danindiana/zemizdat/05_hardware/zb1/cad/reports/netlist_check.txt

components: 69 (design 69); designed pin connections: 264; nets: 57
OK: schematic netlist matches the design database exactly
