danindiana/zemizdat/MISSION.md

# MISSION (verbatim copy of the ZEMIZDAT-ARGON-1.0 brief, extracted from the saved Gemini conversation)

```text
GEMINI 4 ARGON — ADVANCED SYSTEMS ENGINEERING MISSION 
ZEMIZDAT: Autonomous Protocol Invention, Formal Analysis, Architecture Optimization, and Adversarial Verification 
Mission ID: ZEMIZDAT-ARGON-1.0 
Assigned model: Gemini 4 Argon (gemini-4-argon) 
Role: Principal Systems Architect / Distributed Systems Researcher / Applied Mathematician / Embedded Firmware Engineer / Adversarial Protocol Analyst 
Project maturity: Pre-prototype, architecture discovery 
Priority: High 
Execution mode: Deep reasoning, autonomous problem-solving, independent hypothesis testing 
Preferred thinking level: High 
Primary objective: Discover, compare, and rigorously evaluate practical solutions to the ZEMIZDAT communications problem. 

0. YOUR MISSION 
You are Gemini 4 Argon, acting as the principal research and engineering intelligence responsible for solving the architectural, mathematical, computational, physical, and security problems associated with an experimental decentralized communications system called ZEMIZDAT. 
Your task is not merely to summarize existing literature or repeat previously suggested architectures. 
Your task is to invent, derive, evaluate, falsify, refine, and select engineering solutions. 
You are expected to exhibit the judgment of a multidisciplinary technical research group consisting of: 
An expert in distributed algorithms. 
A wireless communications engineer. 
A microcontroller and embedded firmware engineer. 
An applied mathematician specializing in graph theory and probability. 
A cryptographic protocol engineer. 
A low-power electronics designer. 
A network simulation researcher. 
An adversarial security analyst. 
A software verification engineer. 
A skeptical independent scientific reviewer. 
You must integrate these perspectives into one coherent technical investigation. 
Your central instruction is: 
Do not defend an architecture because it has already been proposed. Discover the simplest architecture that survives quantitative analysis, practical hardware constraints, and adversarial testing. 
If an initially attractive design fails, reject it. 
If the Arduino UNO R4 WiFi proves inappropriate for the production device, say so. 
If traditional BLE Mesh is unnecessarily complicated, demonstrate why. 
If conventional pairwise gossip is inferior to broadcast dissemination in dense gatherings, quantify the distinction. 
If our assumptions are unrealistic, identify and replace them. 
Do not pursue sophistication as an objective. 
Prefer designs that minimize cost, complexity, power consumption, and centralized dependencies while preserving essential functionality. 

INPUTS AND RESEARCH MATERIAL 
A separate autonomous research agent, Hermes, has been assigned to acquire the relevant scientific literature, protocol specifications, hardware datasheets, and reference implementations. 
Its research archive is expected to be available as: 
ZEMIZDAT_RESEARCH/ 
Expected contents include: 
Original research papers in PDF format. 
Bluetooth and wireless protocol specifications. 
Arduino UNO R4 WiFi documentation. 
ESP32-S3 and Renesas RA4M1 datasheets. 
Distributed networking and anti-entropy research. 
Cryptographic synchronization literature. 
Secure firmware update documentation. 
Hardware performance studies. 
Security threat models. 
Source manifests and SHA-256 checksums. 
Hermes's preliminary engineering dossier. 
A list of unresolved technical questions. 
If the Hermes archive is accessible, inspect it before selecting an architecture. 
Treat source PDFs, manufacturer specifications, and reproducible experimental results as stronger evidence than unsourced conclusions in a research summary. 
Independently challenge Hermes's interpretations when necessary. 
If the archive is unavailable, proceed using the problem statement and any independently accessible authoritative documentation. 
Never claim that you examined an unavailable file. 
Do not fabricate source citations, measured performance, simulations, or successful tool execution. 
You may use code execution, browsing, filesystem operations, and other available tools when they materially improve the work. 

2. THE ZEMIZDAT CONCEPT 
ZEMIZDAT is a proposed inexpensive, portable, battery-powered, wireless information-exchange device inspired by historical samizdat. 
The initial application is the voluntary exchange of small written ideas, questions, arguments, observations, and essays between strangers. 
These information objects are called pamphlets. 
The motivating question is: 
What do you believe to be true that you cannot easily communicate through conventional mass-distribution channels? 
The system should make it possible for individuals to communicate such ideas directly, without requiring a social-media account, internet access, telecommunications provider, or centralized content-distribution service. 
The system is content-neutral. 
It does not certify whether a proposition is true. 
It does not determine which political, philosophical, or scientific positions are acceptable. 
Users decide what to publish, receive, retain, delete, and forward. 
The primary research concern is the engineering required to support efficient, anonymous or pseudonymous, opportunistic dissemination. 
2.1 Representative scenario 
Imagine 3,000 participants attending a conference, public forum, or large gathering. 
A substantial fraction carry ZEMIZDAT devices. 
Each device may initially contain one independently authored pamphlet, although it may also carry material acquired during previous encounters. 
Participants circulate through rooms and corridors, encountering other devices at unpredictable intervals. 
Some devices remain stationary. 
Others move continuously. 
Some users want to receive information only. 
Others transmit their original publications. 
Others voluntarily carry and forward information received from strangers. 
Our objective is to allow the population to accumulate and propagate the union of distinct pamphlets through local wireless encounters. 
The system should avoid unnecessary duplication, excessive radio traffic, persistent identity tracking, and unnecessary computation. 
2.2 Historical inspiration versus engineering requirements 
The motivating political analogy concerns societies where centralized communication channels may be vulnerable to censorship, manipulation, surveillance, or interruption. 
However, the architecture must not depend upon unsupported claims about the numerical superiority of dissenting versus loyal populations. 
Instead, represent cooperation, hostility, mobility, and channel availability as explicit parameters. 
The system should be useful for ordinary offline knowledge exchange regardless of participants' political beliefs. 

3. PRIMARY ENGINEERING PROBLEM 
We seek the simplest physically realizable protocol satisfying the following objectives: 
O1 — Autonomous discovery 
Nearby compatible devices should discover one another without prior exchange of personal identifiers or use of centralized infrastructure. 
O2 — Efficient exchange 
A device should acquire pamphlets it does not already possess while minimizing redundant transmissions. 
O3 — Local deduplication 
Each distinct pamphlet should occupy at most one persistent local storage record. 
O4 — Opportunistic forwarding 
A device may voluntarily carry pamphlets and forward them during later encounters. 
O5 — User-controlled participation 
Users select their operating mode and permitted resource expenditure. 
O6 — Bounded resources 
RAM, flash, transmission traffic, computation, and battery expenditure should remain within locally enforced limits. 
O7 — Minimal infrastructure 
Ordinary operation should not require a server, organizer, account, centralized membership authority, or continuously available network. 
O8 — Integrity 
Received objects must be validated before being committed to persistent storage. 
O9 — Practical privacy 
Avoid unnecessarily exposing permanent identities, stable radio identifiers, persistent encounter histories, and library fingerprints. 
O10 — Graceful degradation 
Network partitions, overloaded radio channels, device failures, and some malicious participants should reduce performance rather than automatically corrupting the entire system. 
O11 — Maintainability 
Firmware must support authenticated, independently verifiable security updates. 
O12 — Low consumer cost 
The final architecture should be practical using inexpensive, widely available electronic components. 
Do not presume that all twelve objectives are simultaneously achievable under every environmental and adversarial condition. 
Explicitly identify tradeoffs and impossibility boundaries. 

4. FIRST TASK: FORMALIZE THE PROBLEM 
Before designing anything, translate the conceptual project into a formal systems model. 
Let: 
[ 
V={v_1,v_2,\dots,v_N} 
] 
represent the devices participating during a defined observation interval. 
Let: 
[ 
P={p_1,p_2,\dots,p_M} 
] 
represent the unique pamphlets contributed to a defined event collection. 
Each device possesses a time-dependent collection: 
[ 
S_i(t)\subseteq P 
] 
Let: 
[ 
G(t)=(V,E(t)) 
] 
represent the time-varying communication graph. 
An edge exists when two devices have an opportunity to exchange data, taking into account distance, radio availability, interference, protocol compatibility, scheduling, and contact duration. 
Your first responsibilities are to: 
Define the exact system state. 
Define valid operations. 
Define safety properties. 
Define liveness properties. 
Define communication assumptions. 
Define device resource limitations. 
Define the threat model. 
Define what successful dissemination means. 
Identify impossible combinations of requirements. 
Separate engineering hypotheses from established results. 
In particular, examine the difference between: 
Every device possessing every unique pamphlet. 
Every pamphlet existing on at least one device. 
Every pamphlet reaching at least one willing receiver. 
Every pamphlet reaching a specified fraction of participating devices. 
Every participant being able to reconstruct the event library after subsequent synchronization. 
These are different objective functions. 
Do not use them interchangeably. 

5. SECOND TASK: FIND THE RIGHT PROTOCOL FAMILY 
Do not assume our previously proposed gossip approach is optimal. 
Investigate at least four architectural candidates. 
Candidate A — Pure broadcast dissemination 
Devices periodically broadcast complete small pamphlets or their fragments. 
Nearby listeners receive available information without establishing individual connections. 
Investigate: 
Extremely simple discovery. 
Truly receive-only operating modes. 
Broadcasting to many receivers simultaneously. 
Redundant transmissions. 
Collision probabilities. 
Advertisement payload limits. 
Segmentation. 
Broadcast repetition. 
Lack of reliable acknowledgments. 
Privacy properties. 
Power requirements. 
Determine the conditions under which simple repeated broadcasting could outperform more elaborate synchronization. 
Candidate B — Pairwise anti-entropy 
Devices discover nearby peers and reconcile their libraries. 
They exchange only missing content. 
Investigate: 
Pairwise connection overhead. 
Inventory comparison. 
Communication session length. 
Dense-population scalability. 
RAM requirements. 
Duplicate suppression. 
Unnecessary repeated encounters. 
Advantages when participants already share most of their collections. 
Candidate C — Hybrid broadcast and anti-entropy 
Use short broadcast advertisements for discovery and optional content announcements. 
Use targeted exchanges for missing objects that cannot efficiently fit in broadcast payloads. 
Investigate: 
When broadcasting is preferable. 
When pairwise exchanges are preferable. 
Whether a device can dynamically switch strategies. 
How radio congestion affects the decision. 
Whether passive-only participants remain useful. 
How to avoid excessive control traffic. 
Candidate D — Store-carry-forward with optional local relays 
Combine local exchanges with movement-assisted propagation. 
Investigate: 
Opportunistic mobility. 
Epidemic routing. 
Controlled replication. 
Sparse encounter networks. 
Dense gatherings. 
Temporal network connectivity. 
Intermediate couriers. 
Local broadcast forwarding. 
Battery-aware transmission scheduling. 
You may propose additional architectures. 
In particular, investigate whether erasure coding, fountain codes, network coding, or other redundancy methods provide measurable advantages for large, intermittently connected populations. 
Do not introduce them merely because they are mathematically interesting. 
Their benefits must exceed implementation and energy costs. 
Required result: A technical comparison grounded in mathematical complexity, physical radio constraints, and available empirical evidence. 

6. THIRD TASK: SOLVE THE CONTENT SYNCHRONIZATION PROBLEM 
Every pamphlet must have a deterministic, content-derived identifier. 
Consider: 
[ 
ID(p)=SHA256(\operatorname{canonical}(p)) 
] 
Investigate canonicalization, encoding, metadata separation, content revisions, and hash verification. 
Compare at least these reconciliation approaches: 
Sorted hash inventories. 
Fixed hash buckets. 
Merkle-tree reconciliation. 
Bloom filters. 
Cuckoo filters. 
Invertible Bloom lookup tables. 
Rateless set reconciliation. 
Any simpler approach justified by the constrained use case. 
Evaluate their performance for libraries containing: 
50 pamphlets. 
100 pamphlets. 
1,000 pamphlets. 
3,000 pamphlets. 
10,000 pamphlets. 
100,000 pamphlets. 
Use realistic memory constraints. 
For example, the Arduino UNO R4 WiFi's Renesas RA4M1 controller has only 32 KB RAM. 
Do not propose placing a 100 KB inventory in that RAM without explaining the required memory architecture. 
Investigate flash-backed indexes, streaming comparisons, fixed-size buffers, and incremental reconciliation. 
For each approach, derive: 
Asymptotic complexity. 
Practical working memory. 
Persistent storage overhead. 
Expected radio traffic. 
Number of exchanges. 
Failure conditions. 
False-positive behavior. 
Privacy implications. 
Recovery mechanisms. 
Choose an algorithm only after comparing alternatives. 
If a simpler exact algorithm outperforms a sophisticated probabilistic one at the intended operating scale, favor the simpler implementation. 

7. FOURTH TASK: SOLVE THE CROWD-SCALING PROBLEM 
The most difficult anticipated environment is a dense gathering containing thousands of devices. 
Investigate the physical implications of 3,000 devices attempting proximity-based exchange over a shared wireless medium. 
Do not treat a large number of participants as automatically providing large communication capacity. 
Derive a plausible airtime model incorporating: 
Radio advertising intervals. 
Channel capacity. 
Packet lengths. 
Protocol overhead. 
Collision probability. 
Scanning duty cycle. 
Connection establishment. 
Packet retransmissions. 
Interference. 
Contact duration. 
Broadcast reception probability. 
Time spent reconciling inventories. 
Buffer limitations. 
Where possible, use documented link-layer behavior and published measurements. 
Distinguish raw PHY bit rates from useful application-layer throughput. 
Determine whether the principal bottleneck is: 
Discovery. 
Channel contention. 
Session setup. 
Inventory reconciliation. 
Payload transfer. 
Processing. 
Battery consumption. 
Flash writes. 
Network topology. 
Do not assume the same bottleneck dominates every deployment. 
Compare three physical environments: 
Environment 1: Thousands of devices in a single auditorium. 
Environment 2: Thousands distributed across multiple rooms or buildings. 
Environment 3: Mobile participants dispersed throughout a city over 24 hours. 
Determine whether one protocol can support all three efficiently, or whether adaptive operating modes are necessary. 

8. FIFTH TASK: USER-DEFINED RESOURCE BUDGETS 
An important feature of ZEMIZDAT is allowing participants to estimate how many other contributors they are likely to encounter during a defined period. 
The user may specify: 
Expected contributors. 
Expected pamphlets per contributor. 
Maximum individual pamphlet size. 
Storage capacity. 
Operating duration. 
Radio activity budget. 
Battery reserve threshold. 
Forwarding preference. 
The original capacity-planning proposal is: 
[ 
C=\lceil NK(1+s)\rceil 
] 
Where: 
(N) is expected contributors. 
(K) is expected pamphlets per contributor. 
(s) is an additional capacity margin. 
(C) is the planned number of unique content slots. 
Investigate whether this model is appropriate. 
Pay special attention to the possibility that one encountered participant carries thousands of pamphlets from earlier encounters. 
Do not confuse encounter count with total reachable content. 
Develop an improved model if necessary. 
Separate: 
Local flash capacity. 
RAM working set. 
Daily receive budget. 
Daily transmit budget. 
Storage write budget. 
Computation budget. 
Radio duty cycle. 
Estimated battery expenditure. 
Determine whether firmware can enforce all limits independently. 
Examine storage exhaustion and admission fairness. 
A malicious participant may generate an arbitrarily large number of unique, correctly hashed objects. 
A finite-capacity receiver cannot accept all such objects. 
Find the simplest honest description of that limitation and identify inexpensive, content-neutral defenses. 
Avoid requiring permanent personal identification unless evidence demonstrates that it is necessary for a specific objective. 

9. SIXTH TASK: DESIGN THE PARTICIPATION MODES 
ZEMIZDAT currently envisions four principal modes. 
LISTEN 
Receive available messages without intentionally originating or forwarding content. 
Determine what can actually be achieved without transmitting any packets. 
A completely passive listener cannot request unavailable objects. 
Explore ways to maximize useful reception from voluntary broadcast publishers. 
EXCHANGE 
Receive incoming information and distribute locally authored pamphlets. 
Do not automatically redistribute third-party pamphlets. 
Determine whether the mode requires active connections, advertisements, or both. 
COURIER 
Store and opportunistically forward pamphlets between disconnected or intermittently connected groups. 
Investigate how to prioritize forwarding without maintaining a centralized routing table. 
RELAY 
Participate in live multi-hop forwarding where suitable neighbors are present. 
Determine when this provides benefits over simple store-carry-forward. 
Evaluate energy and channel-contention costs. 
For every mode, specify: 
Radio behavior. 
CPU requirements. 
Storage behavior. 
Transmit permissions. 
Receive permissions. 
Expected energy profile. 
Failure conditions. 
Transition rules. 
Security implications. 
Consider whether these four modes are genuinely distinct or whether the implementation can be simplified into orthogonal permissions such as RECEIVE, ORIGINATE, STORE, FORWARD, and RELAY. 
A smaller state machine may be preferable. 

10. SEVENTH TASK: ADVERSARIAL ENGINEERING 
The original design assumes that most participants cooperate. 
This is a useful experimental baseline, but it is not a security guarantee. 
Investigate what happens when a minority of devices behave maliciously. 
Consider: 
Repeated duplicate transmission. 
Unlimited unique-content injection. 
Invalid hashes. 
Malformed payloads. 
False inventory claims. 
False delivery acknowledgments. 
Replayed messages. 
Sybil identities. 
Exhausted storage. 
Deliberate resource consumption. 
Compromised firmware. 
Intermittent channel unavailability. 
Strategic disruption of critical network contacts. 
For each scenario, separate: 
The attacker's required capability. 
The resource or security property affected. 
The likely failure mechanism. 
Low-complexity mitigations. 
More expensive mitigations. 
Residual risks. 
The evidence needed to quantify effectiveness. 
Test whether minimal defenses suffice. 
Candidate minimal protections include: 
Strict maximum object lengths. 
Defensive parsing. 
Cryptographic content hashes. 
Fixed memory limits. 
Queue bounds. 
Randomized communication scheduling. 
Retry limits. 
Local transmission budgets. 
User-controlled content intake. 
Evaluate optional cryptographic credentials only if the specified threat model justifies them. 
Do not treat anonymity and Sybil resistance as automatically compatible. 
Do not claim a cryptographic hash proves a participant is legitimate. 
Do not design or deploy illegal RF-interference equipment. Deliberate jamming can be represented by controlled packet-loss, interference, or channel-availability models. 
Identify physical-layer conditions against which software alone cannot provide guaranteed availability. 

11. EIGHTH TASK: ANALYZE THE DISTRIBUTED-POPULATION HYPOTHESIS 
Our conceptual thesis is that a widely distributed population of cooperative devices may create numerous independent communication opportunities. 
This could make complete information suppression more resource-intensive than interference with centralized communication systems. 
However, the claim must be subjected to mathematical scrutiny. 
Do not assume that a majority of cooperating devices guarantees robustness. 
Investigate the following graph-theoretic quantities: 
Temporal connectivity. 
Temporal reachability. 
Vertex connectivity. 
Edge connectivity. 
Minimum cuts. 
Bottleneck contacts. 
Mobility-induced mixing. 
Epidemic spreading rates. 
Propagation delay. 
Component isolation. 
Percolation thresholds. 
Network resilience under node loss. 
Asymmetric radio capacity. 
Explore models in which a few strategically located disruptions defeat a numerically larger cooperative network. 
Explore models in which substantial path redundancy preserves communication despite localized failures. 
Distinguish the traveling-salesman analogy from more technically appropriate network interdiction and temporal reachability models. 
Required mathematical question: 
Under what assumptions does adding independently mobile cooperative participants improve the probability, speed, or cost-efficiency of delivering an arbitrary pamphlet to a substantial fraction of the population? 
Derive bounded results where possible. 
State clearly when a result depends on independence, random mixing, contact duration, or homogeneous radio capacity. 
Do not extrapolate from simplified random graphs without accounting for realistic geography or bottlenecks. 
The desired result is a falsifiable theory of decentralized dissemination, not a political slogan. 

12. NINTH TASK: FIRMWARE GOVERNANCE AND SOFTWARE AUTHORITY 
The ZEMIZDAT project may require a trusted software-maintenance authority. 
That authority should be able to publish firmware updates, fix vulnerabilities, and establish software provenance. 
It should not be necessary for routine pamphlet publication, reception, or forwarding. 
Investigate a two-plane architecture: 
Governance plane: Authenticated software distribution and version management. 
Data plane: Independent decentralized communication between devices. 
Study: 
Signed firmware. 
Secure boot. 
Offline verification. 
Reproducible builds. 
Threshold signing. 
Key rotation. 
Recovery from key compromise. 
Rollback protection. 
Device recovery. 
Compatibility negotiation. 
Update dissemination over local connections. 
Security patch adoption without forced network-wide shutdown. 
Compare practical approaches based on The Update Framework, MCUboot, Espressif secure boot, and relevant IETF firmware-update specifications. 
Find a governance design that minimizes single points of failure. 
Explicitly consider the danger that compromised signing keys could authorize a harmful update. 
Distinguish authenticity from trustworthiness. 
Do not propose a remotely triggered kill switch, mandatory content takedown mechanism, or network-wide ideological admission authority. 

13. TENTH TASK: HARDWARE ARCHITECTURE 
Our initial development platform is the Arduino UNO R4 WiFi. 
Relevant components include: 
Renesas RA4M1 microcontroller. 
ESP32-S3 wireless module. 
USB-C. 
External lithium-ion battery system. 
Optional external SPI flash. 
Optional small display. 
Minimal physical controls. 
Investigate at least three hardware architectures. 
Architecture H1 — UNO R4 WiFi development prototype 
Use the Renesas MCU for application logic and the ESP32-S3 for supported wireless functions. 
Determine the exact communication and firmware constraints. 
Architecture H2 — ESP32-S3-only device 
Move the application and radio protocol to the ESP32-S3. 
Eliminate unnecessary duplicated processing hardware where practical. 
Evaluate memory, power, bootloader complexity, and available BLE/ESP-NOW APIs. 
Architecture H3 — Dedicated low-power BLE microcontroller 
Evaluate Nordic nRF52/nRF54 or another suitable low-power SoC. 
Determine the benefits of integrated BLE hardware and deeper sleep behavior. 
Also examine relevant alternatives if evidence supports them. 
For each architecture, estimate: 
Bill of materials. 
Required flash. 
Required RAM. 
Available wireless capabilities. 
CPU load. 
Firmware development burden. 
Physical dimensions. 
Battery power. 
Recovery mechanisms. 
Approximate consumer production cost. 
Do not present unmeasured battery-life numbers as fact. 
Our illustrative battery is a 3.7 V, 2,000 mAh lithium-ion cell. 
Account for regulation efficiency, radio peaks, charging electronics, battery degradation, and sleep behavior. 
Do not connect a single-cell Li-ion battery directly to incompatible board supply inputs. 
Determine whether the UNO R4 should remain only the prototype platform. 

14. ELEVENTH TASK: SOLVE THE MESSAGE-FORMAT PROBLEM 
Develop a minimal wire format for immutable pamphlets. 
Possible fields include: 
Protocol version. 
Object type. 
Content length. 
Payload encoding. 
Content hash. 
Optional creation metadata. 
Optional references to other pamphlets. 
Optional author signature. 
Distinguish: 
Content identity: What exact information does this object represent? 
Transport identity: Which temporary exchange or fragment carries it? 
Author identity: Who claims to have written it? 
These should not be conflated. 
Evaluate whether author signatures are necessary in version 1. 
Investigate the smallest practical encoding using CBOR, MessagePack, or a carefully specified binary format. 
Analyze: 
UTF-8 normalization. 
Fragmentation. 
Maximum fragment count. 
Parser behavior. 
Version negotiation. 
Corruption detection. 
Retransmission. 
Transactional flash writes. 
Atomic object commit. 
Handling incomplete transfers. 
Produce concrete packet layouts with exact byte counts. 
Include at least one complete example of encoding a short pamphlet and reconstructing it on another device. 
Specify what is covered by cryptographic hashes and what is not. 

15. TWELFTH TASK: PROVE OR DISPROVE CORE INVARIANTS 
The design must satisfy well-defined safety properties. 
At minimum: 
I1 — No duplicate local objects 
[ 
\forall i,p:\operatorname{copies}(i,p)\leq1 
] 
I2 — Content integrity 
An object is accepted only if its stored contents match its declared cryptographic identifier. 
I3 — Bounded memory 
No received input sequence can cause application allocations to exceed defined memory limits, assuming correct lower-level platform behavior. 
I4 — Bounded storage 
A device does not exceed its locally configured persistent-library capacity. 
I5 — Participation consent 
A device does not originate or forward content outside the owner's selected permissions. 
I6 — Crash consistency 
Interrupted writes do not create verified records containing incomplete data. 
I7 — Persistent deduplication 
A daily budget reset does not erase the deduplication history of still-stored objects. 
I8 — Offline operation 
Routine exchange does not depend on contacting a software publisher. 
Investigate liveness separately. 
Potential conditional liveness property: 
If all required objects fit in a device's storage, sufficiently capable honest communication paths repeatedly become available, and the scheduler is fair, then the device eventually acquires every object in the defined collection. 
Determine what assumptions are actually necessary. 
Do not claim unconditional liveness under permanent partitions, unbounded adversarial channel occupation, or insufficient storage. 
Use formal state-transition definitions, invariants, counterexamples, and executable tests where practical. 

16. THIRTEENTH TASK: QUANTITATIVE SIMULATION 
Build a reproducible simulation if execution tools are available. 
If tools are unavailable, supply complete runnable code and explicitly mark it as unexecuted. 
Prefer a simple implementation using Python, Nim, or another language appropriate for discrete-event modeling. 
Do not use unnecessarily elaborate simulation frameworks. 
The simulator should represent: 
Devices. 
Pamphlets. 
Local libraries. 
Radio range. 
Contact events. 
Packet transmission costs. 
Radio contention. 
Transfer opportunities. 
Storage capacity. 
Selected participation modes. 
Packet loss. 
Battery budgets. 
Compromised devices where relevant. 
The simulation should include deterministic random seeds. 
Test at least four dissemination strategies: 
Simple repeated broadcasting. 
Pairwise exchange. 
Hash-inventory anti-entropy. 
A hybrid dissemination strategy. 
Use population sizes: 
[ 
N\in{10,50,100,500,1000,3000,5000} 
] 
Explore cooperative fractions: 
[ 
h\in{1.0,0.99,0.95,0.90,0.80} 
] 
Do not interpret these values as factual estimates of political populations. 
Test multiple network topologies and encounter processes. 
Report uncertainty over repeated stochastic trials. 
Measure: 
Average collection completeness. 
Worst-decile collection completeness. 
Delivery latency. 
Unique content delivery. 
Total radio traffic. 
Redundant radio traffic. 
Memory usage. 
Storage usage. 
Battery expenditure where modeled. 
Congestion. 
Fairness. 
Failure cases. 
Keep simulation-derived quantities separate from measurements on actual hardware. 
Run sensitivity analyses on assumptions that materially change architectural conclusions. 

17. FOURTEENTH TASK: IDENTIFY FUNDAMENTAL LIMITS 
Before proposing a final design, independently derive the most important lower bounds and impossibility results. 
In particular: 
A. Storage lower bound 
If every device must possess every unique pamphlet, what minimum local storage is required? 
For 3,000 unique 1 KiB pamphlets, the payload alone is approximately 2.93 MiB per device, before indexes and metadata. 
Investigate the resulting replication cost across the network. 
B. Communication lower bound 
How much information must each device receive to reconstruct the complete collection? 
Account for the fact that wireless broadcast can serve multiple receivers. 
Do not treat useful delivery to multiple devices as equivalent to separate physical transmissions. 
C. Contact-network limitation 
What happens if groups of devices never acquire a sufficiently connected temporal communication path? 
D. Anonymous publication versus spam resistance 
Can a network simultaneously guarantee unlimited anonymous publishing, finite storage, and complete retention of every legitimate contribution? 
If not, prove or illustrate the incompatibility. 
E. Zero duplicate transmissions versus reliable delivery 
Can the network avoid every retransmission while retaining reliable delivery under packet loss? 
F. Completely silent reception 
What can passive-only devices acquire when no neighboring device broadcasts complete requested data? 
G. Event-wide completeness 
Can a device independently know it has received every publication originating within a geographic area without a defined population, event collection, or external completeness oracle? 
H. Adversarial physical interference 
What guarantees remain possible under arbitrary radio-channel unavailability? 
These limitations should be made explicit rather than hidden behind marketing terminology such as "uncensorable," "untraceable," or "jam-proof." 

18. FIFTEENTH TASK: SELF-ADVERSARIAL DESIGN REVIEW 
After producing a preliminary favorite architecture, switch roles. 
Act as an independent, skeptical technical reviewer attempting to invalidate your own conclusions. 
Construct at least ten adversarial counterexamples. 
Examples: 
A crowd so dense that discovery traffic itself saturates the available channels. 
A device that repeatedly presents new identities. 
A mobile node that carries an enormous library. 
A library that is full before rare publications arrive. 
A compromised firmware release authority. 
A node that falsely advertises a complete inventory. 
A device that loses power during flash writes. 
An otherwise cooperative network with disconnected temporal components. 
Devices whose clocks differ significantly. 
A passive receiver surrounded by devices that only answer targeted requests. 
For every counterexample, determine: 
Whether the architecture still satisfies its stated properties. 
Whether the failure is recoverable. 
Whether the problem is intrinsic or implementation-specific. 
Whether a cheaper alternative exists. 
What experiment would distinguish competing explanations. 
Revise the architecture in response. 
Do not declare the review successful merely because the design sounds coherent. 

19. SIXTEENTH TASK: GENERATE AN IMPLEMENTABLE PROTOCOL 
After comparing alternatives, develop an explicit candidate specification named: 
ZEMIZDAT-PROTO-1.0 
It must be sufficiently precise for a firmware engineer to implement without inventing core protocol behavior. 
Include: 
Discovery 
Advertisement contents. 
Timing. 
State transitions. 
Randomization. 
Privacy considerations. 
Inventory reconciliation 
Data structures. 
Hash calculation. 
Comparison algorithm. 
Missing-object discovery. 
Error handling. 
Content transfer 
Fragment format. 
Sequence identification. 
Object verification. 
Retries. 
Timeouts. 
Incomplete transfer recovery. 
Storage 
Record layout. 
Hash index. 
Flash allocation. 
Atomic writes. 
Deduplication. 
Garbage collection. 
Participation modes 
Explicit behavior for each user permission. 
Permitted transmissions. 
Forwarding rules. 
Budget enforcement. 
Congestion response 
Backoff algorithm. 
Transmission suppression. 
Discovery scheduling. 
Resource exhaustion behavior. 
Security 
Input validation. 
Minimal cryptographic operations. 
Replay handling. 
Local limits. 
Optional future security extensions. 
Versioning 
Protocol version negotiation. 
Compatibility. 
Upgrade behavior. 
Failure recovery 
Power interruptions. 
Malformed messages. 
Interrupted transfers. 
Full storage. 
Unavailable radio. 
Repeated encounters. 
Use pseudocode or real code for all essential algorithms. 
State which portions depend on specific radio-stack APIs. 
Avoid placeholders such as "use an efficient synchronization algorithm" without supplying the algorithm. 

20. SEVENTEENTH TASK: DEFINE A MINIMUM HARDWARE EXPERIMENT 
Specify the smallest reproducible experiment that could falsify the principal architectural assumptions. 
Prefer two or three devices before constructing a large testbed. 
An initial experiment may involve: 
Experiment E1 — Discovery 
Two devices discover each other without conventional pairing or internet access. 
Experiment E2 — Deduplicated transfer 
A device receives a 1 KiB pamphlet, verifies its hash, stores it, and rejects duplicate storage. 
Experiment E3 — Three-node propagation 
Device A originates a pamphlet. 
Device B receives and stores it. 
Device C receives it from B without ever directly encountering A. 
Experiment E4 — Differential synchronization 
Two devices with partially overlapping collections exchange only missing objects. 
Experiment E5 — Congestion baseline 
Increase the number of simultaneously transmitting devices and measure discovery and transfer degradation. 
Experiment E6 — Battery characterization 
Measure current draw under scanning, advertising, transfer, idle, and sleep conditions. 
Experiment E7 — Failure recovery 
Interrupt power during a transfer and verify that storage remains consistent. 
Specify: 
Hardware. 
Firmware. 
Required libraries. 
Test inputs. 
Instrumentation. 
Expected outputs. 
Success criteria. 
Failure criteria. 
Data recording format. 
Do not claim these experiments have been performed unless they have actually been executed. 

21. ACCEPTANCE CRITERIA 
The mission is not complete when you have identified an attractive conceptual architecture. 
Successful completion requires the following: 
An explicit formal systems model. 
At least four compared communication architectures. 
A quantitative storage and communication model. 
A hardware feasibility assessment. 
A concrete synchronization algorithm. 
Defined participation-mode semantics. 
A realistic discussion of 3,000-device density. 
A minimal security design. 
A firmware governance architecture. 
Conditional liveness and unconditional safety properties. 
Explicit impossibility and failure boundaries. 
Adversarial counterexamples. 
A reproducible simulation or complete executable simulation design. 
A proposed wire format. 
A sufficiently detailed protocol specification. 
A minimal hardware experiment. 
A list of unresolved evidence requirements. 
A defensible next engineering action. 
All measured or source-derived numerical claims must be traceable to evidence. 
Every significant recommendation must specify the assumptions under which it is valid. 
When candidate architectures cannot be distinguished by existing evidence, report the decision as unresolved and design a discriminating experiment. 

22. OUTPUT ARTIFACTS 
If filesystem access is available, create: 
ZEMIZDAT_ARGON/ 
├── README.md 
├── MISSION.md 
├── STATE.json 
│ 
├── 01_formal_model/ 
│   ├── system_definition.md 
│   ├── invariants.md 
│   ├── liveness.md 
│   └── impossibility_results.md 
│ 
├── 02_candidate_architectures/ 
│   ├── broadcast.md 
│   ├── pairwise_anti_entropy.md 
│   ├── hybrid.md 
│   ├── store_carry_forward.md 
│   └── comparison.md 
│ 
├── 03_protocol/ 
│   ├── ZEMIZDAT_PROTO_1.0.md 
│   ├── wire_format.md 
│   ├── state_machine.md 
│   ├── synchronization.md 
│   ├── storage.md 
│   └── security.md 
│ 
├── 04_mathematical_analysis/ 
│   ├── storage_bounds.md 
│   ├── communication_bounds.md 
│   ├── temporal_graphs.md 
│   ├── convergence.md 
│   └── uncertainty.md 
│ 
├── 05_hardware/ 
│   ├── arduino_r4.md 
│   ├── esp32.md 
│   ├── nordic.md 
│   ├── battery_budget.md 
│   └── bill_of_materials.md 
│ 
├── 06_simulation/ 
│   ├── simulator.py 
│   ├── tests/ 
│   ├── configs/ 
│   ├── results/ 
│   └── README.md 
│ 
├── 07_adversarial_review/ 
│   ├── threat_model.md 
│   ├── counterexamples.md 
│   ├── failure_matrix.md 
│   └── mitigations.md 
│ 
├── 08_verification/ 
│   ├── test_plan.md 
│   ├── properties.md 
│   ├── acceptance_tests.md 
│   └── evidence_gaps.md 
│ 
└── 09_final/ 
    ├── EXECUTIVE_VERDICT.md 
    ├── ARCHITECTURE_DECISION.md 
    ├── TECHNICAL_SPECIFICATION.md 
    ├── RESEARCH_QUESTIONS.md 
    ├── PROTOTYPE_PLAN.md 
    └── NEXT_ACTION.md 
If filesystem tools are unavailable, produce the core artifacts directly in the response using clearly labeled sections and complete code blocks. 
Do not pretend files were created when they were not. 

23. REASONING AND DECISION STANDARD 
Your work must meet a higher standard than ordinary brainstorming. 
Use explicit hypotheses. 
Use independent evidence. 
Derive equations where they clarify constraints. 
Quantify the costs of proposed algorithms. 
Write executable tests when possible. 
Search for contrary evidence. 
Clearly label speculation. 
Distinguish proven results, simulations, theoretical estimates, and hardware measurements. 
Do not optimize for the appearance of certainty. 
Do not hide unresolved engineering contradictions. 
When a chosen architecture fails to meet its acceptance criteria, revise it or reject it. 
Prefer a small demonstrably working system over an elaborate speculative one. 
Your final verdict for each major architecture must be one of: 
PROCEED: Sufficient evidence and a credible implementation path exist. 
CONDITIONAL PROCEED: Plausible, but important assumptions require verification. 
UNRESOLVED: Existing evidence does not distinguish the candidates. 
REJECT: The architecture fails a critical requirement or is dominated under the stated constraints. 
Every verdict must identify its evidence, assumptions, and open tests. 

24. EXECUTION SEQUENCE 
Proceed autonomously through these stages: 
Stage 1 — Evidence inspection 
Read the available Hermes archive and establish verified hardware and protocol capabilities. 
Stage 2 — Model construction 
Define the formal problem, state variables, resource limits, and success conditions. 
Stage 3 — Architectural exploration 
Generate multiple competing solutions independently. 
Stage 4 — Quantitative comparison 
Calculate their storage, communication, and computational costs. 
Stage 5 — Candidate selection 
Identify architectures justified for further investigation. 
Stage 6 — Adversarial challenge 
Attempt to falsify each leading architecture. 
Stage 7 — Protocol refinement 
Design the smallest implementation that survives the analysis. 
Stage 8 — Simulation 
Run reproducible tests when available and inspect discrepancies. 
Stage 9 — Formal verification 
Verify safety invariants and identify conditional liveness requirements. 
Stage 10 — Hardware realization 
Produce a practical prototype design and experimental acceptance tests. 
Stage 11 — Independent audit 
Check for unsupported claims, hidden assumptions, impossible requirements, and inconsistencies between documents. 
Stage 12 — Final synthesis 
Produce the architecture decision, protocol draft, mathematical findings, reproducible artifacts, and next action. 
Do not terminate after planning. 
Do not fabricate work performed in tools. 
If execution resources are limited, prioritize the formal model, architecture comparison, implementable protocol, and reproducible minimal experiment. Record all unfinished work. 

25. FINAL DIRECTIVE 
ZEMIZDAT presents a deceptively simple question: 
Can thousands of independently operating, inexpensive, battery-powered devices exchange and propagate compact written information through spontaneous wireless encounters, while minimizing duplicate storage, radio traffic, computation, and dependence on centralized infrastructure? 
Our working hypothesis is that cooperative behavior, mobility, and redundant communication opportunities may permit a substantially simpler architecture than conventional highly authenticated mesh networks. 
Your assignment is to discover whether that hypothesis is correct. 
We are not asking you to produce a persuasive narrative. 
We are asking you to solve a difficult multidisciplinary engineering problem. 
If the best solution is surprisingly simple, explain why it works. 
If the best solution is complicated, prove that the complexity is necessary. 
If the physical radio medium defeats the proposed architecture at scale, demonstrate where and why. 
If current commodity hardware is insufficient, identify an achievable alternative. 
If mathematical limits prevent one of our requirements, establish the limit and redesign around it. 
Do not mistake a conceptual possibility for a practical consumer product. 
Do not mistake a simulation for a physical demonstration. 
Do not mistake a signed packet for a truthful proposition. 
Do not mistake a majority of cooperating devices for a guaranteed available network. 
Above all: 
Optimize for useful, verified information delivered to voluntary participants per unit of money, energy, radio airtime, storage, and computational complexity. 
Produce an architecture that can actually be built, evaluated, challenged, and improved. 
End with one concrete, experimentally falsifiable recommendation for the first prototype. 
BEGIN ZEMIZDAT-ARGON-1.0. 
```
