danindiana/zemizdat/09_final/AUDIT_OF_GEMINI_RUN.md

# Audit of the prior run (Gemini, "ZEMIZDAT-ARGON-1.0", truncated)

The prior response had no filesystem or code execution and stopped mid-way through its C
reference code. This tree supersedes it. Every point below was checked in this session;
"executed" means verified by running code here.

| # | Prior claim | Finding | Evidence | Consequence in this tree |
|---|---|---|---|---|
| 1 | Worked example digest `9f86d081…0a08` "illustrative deterministic digest" of the 42-byte preimage | **Fabricated.** That value is SHA-256("test"). The real digest of its own preimage is `b9fdb3e2106aa6888e072fca3adda651574a7f911bb20ef494f34072b771dad6`. | executed | all hex in `wire_format.md` is generated by the reference code |
| 2 | "12-byte canonical header" | Layout shown was 8 bytes. | inspection | v1 header is 12 bytes and the layout says so |
| 3 | SDB = 64 × 32-bit XOR folds | **Linear over GF(2): leaks the library.** One beacon recovers 100 % (M = 300) / 97 % (M = 1 000) of a courier's library to anyone knowing the universe; 58 % of bits at M = 3 000. | executed (`xor_digest_attack.py`) | salted SHA-256 digests; beacons optional, off by default |
| 4 | Pairwise unicast needs "> 102 hours" for 3 000 × 3 000 KiB | Assumed one 200 kbit/s channel. BLE connections use 37 data channels; under an assumed 13.6 Mbit/s aggregate it is ≈ 1.6 h. | executed (`airtime_model.py`) | broadcast advantage restated as ≈ 100× in bits on air (one copy per reception tile), not 3 000× |
| 5 | Broadcast lower bound "123 seconds of airtime" in an auditorium | Ignores that reception range ≪ interference range (one copy needed per reception tile) and scan duty. | estimate | per-receiver bound ≈ 24 min at 30 % scan duty |
| 6 | Channel model: 37 secondary channels as capacity | Ignores the **primary-channel pointer bottleneck** (3 channels × 136 µs per event) and AUX-chain truncation. Optimal chain is ~3 PDUs. | executed (`airtime_model.py`) | `L_CHAIN = 3`, separate primary/secondary load targets |
| 7 | ESP-NOW "250-byte vendor action frames" | ESP-NOW v2 carries 1 470 B. | ESP-IDF docs | ESP-NOW re-evaluated as UNRESOLVED alternative |
| 8 | Candidate B (pairwise) "catastrophic collapse … CONNECT_IND frames collide 100 %" | Overstated. In simulation, pairwise anti-entropy is **competitive for transmitting devices** in a dense hall under the stated link assumptions; its decisive failures are LISTEN exclusion (0 % for listeners) and per-pair unicast cost. | simulated (group A) | B rejected as the primary design for the right reasons |
| 9 | IBLT "fails catastrophically" for large differences; rateless reconciliation needs "GF(2⁶⁴) matrix inversion" | Conflates fixed-size IBLT, rateless IBLT (XOR/hash only, ~1.35 |D| symbols, no size estimate needed) and PinSketch (BCH). | literature | rateless IBLT kept as a v2 option for courier-to-courier sync |
| 10 | Whole-object SHA-256 only; fragments verified at the end | A single forged fragment poisons reassembly; fragments from different senders cannot be mixed safely. | design analysis | hash-list id with per-chunk leaves (I9) |
| 11 | Trickle suppression on overheard pamphlet headers | **Spoofable by construction**: a forged header deprioritises the item at every honest holder in range. (In our N = 500 simulation the effect was not measurable — spare capacity.) | design analysis | verified suppression (I10), cheap |
| 12 | `hop_count` in every fragment | hop = 0 identifies the author to every listener. | design analysis | field removed |
| 13 | Proof-of-work nonce as spam defence | Asymmetric the wrong way: GPU adversaries out-hash battery MCU authors by orders of magnitude. | estimate | reserved field kept, not relied on |
| 14 | Flash endurance caps writes at "≤ 5 000 objects/day for 5 years" | Not derived; arithmetic gives ≈ 1.4 × 10⁵/day for 8 MB NOR at 100 k cycles. | estimate | endurance not a binding budget |
| 15 | Liveness proof via "second Borel–Cantelli" and "with probability 1, lim Pr[…] = 1" | Independence not available; a.s. vs in-probability conflated. | proof review | Theorem L1 restated with conditional per-contact success |
| 16 | Theorem 10 epidemic bound and `h_crit = 1/(d̄γ)` presented as derived | Constants and conditions unsupported. | review | replaced by simulated scaling + clearly labelled heuristics |
| 17 | Mode power figures (e.g. "~1.6 mA avg nRF52840", "~55 mA ESP32-S3 RELAY") | Unsourced. | review | datasheet-based arithmetic with stated assumptions; E6 required |
| 18 | RELAY as a fifth mode | No mechanism shown to add value over a carousel in a shared interference domain. | analysis | rejected as a mode |
| 19 | "Hardware PA disabled at HAL level" for LISTEN | Not a generally exposed control; passive scanning plus no advertising set is the actual mechanism. | review | I5 restated; spectrum check E-L |
| 20 | BOM "$9–$14 at scale" for nRF design | Unsourced. | review | ranges marked unverified |
| 21 | C reference engine | Truncated mid-function. | — | complete C99 receive path, cross-checked against Python, fuzzed under sanitizers |

Points where the prior run was right and is retained: separating content / transport / author
identity; refusing pairwise-only designs because of LISTEN; orthogonal permission bits; the
anonymous-publishing trilemma (restated with a cleaner proof); the bridge-cut interdiction
argument; rejecting the UNO R4's RA4M1 for production; rejecting standard BLE Mesh (network keys
and sequence numbers create identities and administration).
