danindiana/zemizdat/05_hardware/zb1/pinmap.csv

gpio | module_pin_function | zb1_net | arduino_name | direction | notes
0 | strap BOOT | BTN_BOOT | ZB1_BTN_BOOT | in | BOOT/user button to GND; 10k pull-up; held at reset = download mode; held at sketch start = LISTEN role
1 | ADC1_CH0 / TOUCH1 | A4 | A4 | io | header
2 | ADC1_CH1 | VBAT_SENSE | ZB1_VBAT_SENSE | in (analog) | VBAT via 1M/1M divider + 100nF; ADC1 so it works while the radio runs
3 | strap JTAG source | NC |  | - | strapping pin with no internal pull; not connected (JTAG source then follows the eFuse default)
4 | ADC1_CH3 | A0 | A0 | io | header
5 | ADC1_CH4 | A1 | A1 | io | header
6 | ADC1_CH5 | A2 | A2 | io | header
7 | ADC1_CH6 | A3 | A3 | io | header
8 | GPIO | I2C_SDA | SDA | io | STEMMA-QT + optional MAX17048; 4.7k pull-up to 3V3
9 | SDMMC via GPIO matrix | SD_D2 | ZB1_SD_D2 | io | 10k pull-up to SD_VDD
10 | FSPI CS0 (IOMUX) | SD_D3 | ZB1_SD_D3 | io | 10k pull-up; = CS in SPI mode (SdFat/exFAT path uses IOMUX FSPI pins 10-13)
11 | FSPI D (IOMUX) | SD_CMD | ZB1_SD_CMD | io | 10k pull-up; = MOSI in SPI mode
12 | FSPI CLK (IOMUX) | SD_CLK | ZB1_SD_CLK | out | 33R series resistor at module; = SCK in SPI mode
13 | FSPI Q (IOMUX) | SD_D0 | ZB1_SD_D0 | io | 10k pull-up; = MISO in SPI mode
14 | GPIO | SD_D1 | ZB1_SD_D1 | io | 10k pull-up
15 | XTAL_32K_P | XTAL32_P | ZB1_XTAL32_P | analog | 32.768 kHz crystal (BLE low-power sleep clock); not a GPIO in ZB-1
16 | XTAL_32K_N | XTAL32_N | ZB1_XTAL32_N | analog | 32.768 kHz crystal
17 | GPIO | D5 | D5 | io | header
18 | GPIO | I2C_SCL | SCL | io | 4.7k pull-up to 3V3
19 | USB D- | USB_DN |  | io | native USB (CDC + JTAG); via USBLC6-2SC6 ESD
20 | USB D+ | USB_DP |  | io | native USB
21 | RTC GPIO | SD_PWR_EN | ZB1_SD_PWR_EN | out | TPS22917 ON; 100k pull-down so the card is off during reset and deep sleep
26 | GPIO (free on -N8 only) | SD_DETECT | ZB1_SD_DETECT | in | socket card-detect switch to GND; 100k pull-up to 3V3; on -N4R2 modules IO26 is PSRAM: do not substitute
33 | GPIO | D11 | D11 | io | header
34 | GPIO | D12 | D12 | io | header
35 | GPIO | NC |  | - | spare; not connected on rev 0.1 (octal-PSRAM pins on other module variants)
36 | GPIO | NC |  | - | spare; not connected on rev 0.1 (octal-PSRAM pins on other module variants)
37 | GPIO | NC |  | - | spare; not connected on rev 0.1 (octal-PSRAM pins on other module variants)
38 | GPIO | D10 / SS | D10 | io | header
39 | GPIO (MTCK) | D6 | D6 | io | header
40 | GPIO (MTDO) | D9 | D9 | io | header
41 | GPIO (MTDI) | SCK | SCK | io | header SPI
42 | GPIO (MTMS) | MOSI | MOSI | io | header SPI
43 | U0TXD | TX | TX | out | header; ROM boot log
44 | U0RXD | RX | RX | in | header
45 | strap VDD_SPI | NC |  | - | must stay low at reset (3.3 V flash); no connection
46 | strap boot/ROM log | NC |  | - | must not be pulled high at reset; no connection
47 | GPIO | LED | LED_BUILTIN | out | red LED + 2.2k (~0.6 mA)
48 | GPIO | MISO | MISO | io | header SPI
EN | CHIP_PU | EN |  | in | 10k pull-up + 1uF to GND; RESET button to GND
