danindiana/zemizdat/05_hardware/zb1/cad/images/zb1_3d_usb_end.png

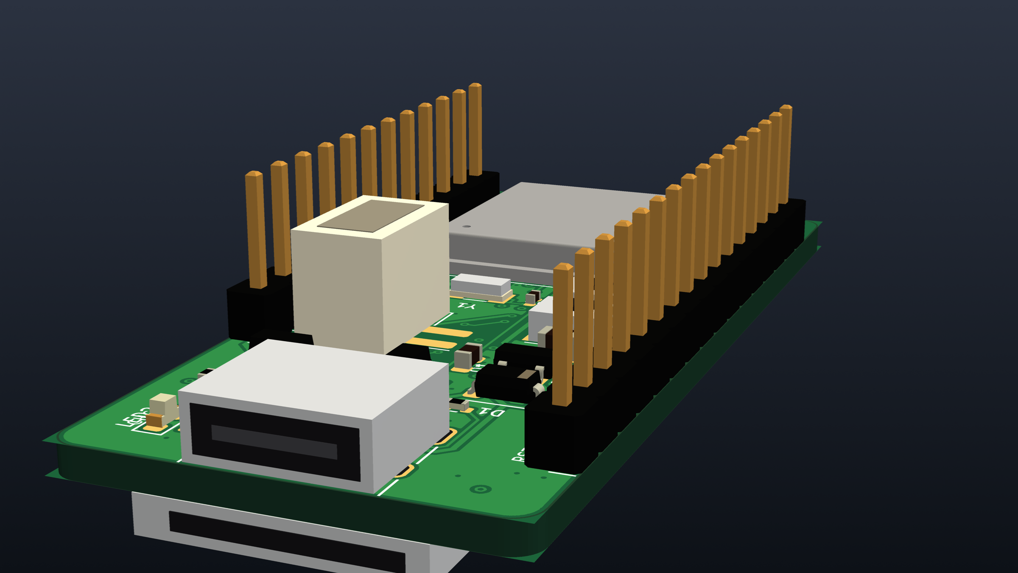
05_hardware/zb1/cad/images/zb1_3d_usb_end.png
