danindiana/zemizdat/05_hardware/zb1/cad/images/zb1_surface_bottom.png

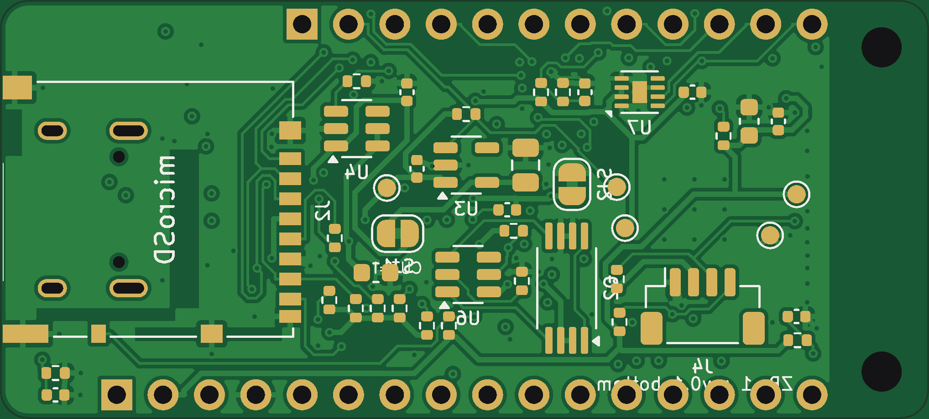
05_hardware/zb1/cad/images/zb1_surface_bottom.png
