danindiana/zemizdat/05_hardware/zb1/bom.csv

ref | qty | part | package | function | unit_usd_qty100 | price_basis | populate
U1 | 1 | ESP32-S3-MINI-1-N8 | module 15.4x20.5 mm | MCU + BLE 5 + Wi-Fi + 8 MB flash + PCB antenna | 2.90 | estimate | yes
U2 | 1 | TI BQ21040DBVR | SOT-23-6 | 1-cell Li-ion linear charger (ISET 500 mA; TS input; /CHG) | 0.55 | estimate | yes
U3 | 1 | Richtek RT9080-33GJ5 | SOT-23-5 | 3.3 V 600 mA LDO; 2 uA Iq; EN broken out for power-cut tests | 0.20 | estimate | yes
U4 | 1 | TI TPS22917DBVR | SOT-23-6 | microSD power load switch (1 uA leakage off) | 0.30 | estimate | yes
U5 | 1 | ST USBLC6-2SC6 | SOT-23-6 | USB D+/D- ESD protection | 0.12 | estimate | yes
U6 | 1 | Fortune DW01A | SOT-23-6 | battery protection controller (only if cell has no PCM) | 0.04 | estimate | optional
Q2 | 1 | FS8205A | TSSOP-8 | dual N-MOSFET for DW01A | 0.05 | estimate | optional
U7 | 1 | Analog Devices MAX17048G+T10 | TDFN-8 2x2 | fuel gauge (I2C) - adds 23 uA; ADC divider is default | 1.20 | estimate | DNP
Q1 | 1 | DMG3415U | SOT-23 | P-MOSFET load-sharing power path (battery -> VSYS when USB absent) | 0.05 | estimate | yes
D1 | 1 | B5819W (or SS14) | SOD-123 | Schottky VBUS -> VSYS | 0.03 | estimate | yes
J1 | 1 | USB-C 16-pin receptacle (USB 2.0) | SMD mid-mount | power + native USB | 0.25 | estimate | yes
J2 | 1 | microSD push-push socket with card-detect | SMD | storage archive (SDSC/SDHC/SDXC) | 0.30 | estimate | yes
J3 | 1 | JST PH 2-pin vertical (B2B-PH-SM4-TB) | SMD | LiPo battery (top entry; side entry does not fit beside USB-C) | 0.06 | estimate | yes
J4 | 1 | JST SH 4-pin vertical (BM04B-SRSS-TB; STEMMA-QT/Qwiic) | SMD | I2C expansion (bottom side) | 0.10 | estimate | yes
J5/J6 | 2 | 1x16 and 1x12 2.54 mm headers | TH | Feather headers | 0.20 | estimate | ship loose
Y1 | 1 | 32.768 kHz crystal 12.5 pF | 3215 | BLE low-power clock | 0.15 | estimate | yes
SW1/SW2 | 2 | tactile switch 3x4 mm | SMD | RESET and BOOT | 0.04 | estimate | yes
LED1 | 1 | red LED | 0603 | user LED (GPIO47) | 0.01 | estimate | yes
LED2 | 1 | orange LED | 0603 | charge (/CHG) | 0.01 | estimate | yes
R1/R2 | 2 | 5.1k 1% | 0402 | USB-C CC1/CC2 pull-downs (sink) | 0.002 | estimate | yes
R3 | 1 | 1.07k 1% | 0402 | BQ21040 ISET -> ~500 mA (K_ISET 540 A·ohm; check datasheet) | 0.002 | estimate | yes
R4 | 1 | 10k 1% (or 10k NTC on cell) | 0402 | BQ21040 TS | 0.002 | estimate | yes
R5/R6 | 2 | 1M 1% | 0402 | VBAT divider | 0.002 | estimate | yes
R7 | 1 | 100k | 0402 | Q1 gate pull-down | 0.002 | estimate | yes
R8 | 1 | 1M | 0402 | LDO EN pull-up (TP_EN pad pulls low for E7 power cuts) | 0.002 | estimate | yes
R9-R14 | 6 | 10k | 0402 | SD CMD/D0-D3 pull-ups + EN pull-up | 0.002 | estimate | yes
R15 | 1 | 33R | 0402 | SD_CLK series | 0.002 | estimate | yes
R16/R17 | 2 | 100k | 0402 | SD_DETECT pull-up; SD_PWR_EN pull-down | 0.002 | estimate | yes
R18/R19 | 2 | 4.7k | 0402 | I2C pull-ups | 0.002 | estimate | yes
R20/R21 | 2 | 2.2k / 1k | 0402 | LED resistors | 0.002 | estimate | yes
C* | ~16 | MLCC 100nF / 1uF / 10uF / 22uF | 0402-0805 | decoupling + bulk (22uF on VSYS and 3V3 for TX bursts; 10uF on SD_VDD) | 0.20 total | estimate | yes
SJ1 | 1 | solder jumper (closed) | pads | cut to insert ammeter between LDO and module (E6) | 0 | - | yes
PCB | 1 | 4-layer 50.8 x 22.86 mm FR-4 1.6 mm ENIG | - | Feather form factor | 1.60 | estimate | yes
ASSY | 1 | SMT assembly (one side) | - | - | 2.50 | estimate | -
