danindiana/zemizdat/05_hardware/zb1/cad/3d/zb1.step

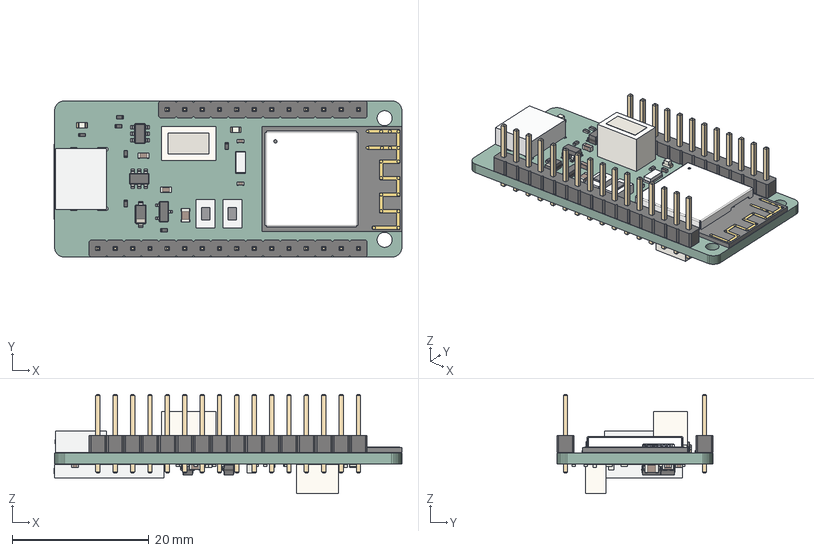
[picture p28: CAD file, 2026-10-20]
05_hardware/zb1/cad/3d/zb1.step
50.9 x 22.9 x 14.5 mm
LED_0603_1608Metric x 2
R_0402_1005Metric x 23
C_0603_1608Metric x 4
PinHeader_1x16_P254mm_Vertical
ESP32-S3-MINI-1_20211021
C_0805_2012Metric x 2
SOT_23_6 x 3
C_0402_1005Metric x 8
PinHeader_1x12_P254mm_Vertical
SOT_23
D_SOD_123
SOT_23_5
zb1 PCB
