danindiana/zemizdat/06_simulation/results/summary.md

# Simulation results (generated by analyze.py — SIMULATION, not measurement)

377 runs.

## Group A — population sweep, one auditorium (1 person/m², 60 min)

Mean completeness of honest receivers (± s.d. over seeds) / worst-decile (p10) / listener mean / median time for a pamphlet to reach 80 % of receivers (s) / fraction of pamphlets that reached 80 % / mean G.

| N | strategy | seeds | mean | p10 | LISTEN | t80 (s) | reach80 | tx events | G |
|---|---|---|---|---|---|---|---|---|---|
| 10 | HYBRID | 3 | 1.000 ± 0.000 | 1.000 ± 0.000 | 1.000 ± 0.000 | 60 | 1.000 ± 0.000 | 4.5e+04 | 0.00 |
| 10 | AE_INV | 3 | 0.700 ± 0.100 | 0.000 ± 0.000 | 0.000 ± 0.000 | 840 | 0.333 ± 0.577 | 0 | 0.01 |
| 10 | PAIRWISE | 3 | 0.700 ± 0.100 | 0.000 ± 0.000 | 0.000 ± 0.000 | 270 | 0.333 ± 0.577 | 0 | 0.01 |
| 10 | BCAST_RC | 3 | 1.000 ± 0.000 | 1.000 ± 0.000 | 1.000 ± 0.000 | 60 | 1.000 ± 0.000 | 6.24e+05 | 0.04 |
| 10 | BCAST | 3 | 1.000 ± 0.000 | 1.000 ± 0.000 | 1.000 ± 0.000 | 60 | 1.000 ± 0.000 | 2.5e+05 | 0.02 |
| 50 | HYBRID | 3 | 1.000 ± 0.000 | 1.000 ± 0.000 | 1.000 ± 0.000 | 60 | 1.000 ± 0.000 | 3.76e+05 | 0.02 |
| 50 | AE_INV | 3 | 0.833 ± 0.012 | 0.000 ± 0.000 | 0.000 ± 0.000 | 430 | 1.000 ± 0.000 | 0 | 0.06 |
| 50 | PAIRWISE | 3 | 0.833 ± 0.012 | 0.000 ± 0.000 | 0.000 ± 0.000 | 470 | 1.000 ± 0.000 | 0 | 0.06 |
| 50 | BCAST_RC | 3 | 1.000 ± 0.000 | 1.000 ± 0.000 | 1.000 ± 0.000 | 60 | 1.000 ± 0.000 | 3.75e+06 | 0.23 |
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
| flood | 0.99 | AE_INV | yes | 0.797 ± 0.009 | 0.000 ± 0.000 | 0.28 |
| flood | 0.99 | BCAST_RC | yes | 0.816 ± 0.007 | 0.807 ± 0.009 | 0.44 |
| flood | 0.95 | HYBRID | yes | 0.997 ± 0.001 | 0.995 ± 0.003 | 0.50 |
| flood | 0.95 | AE_INV | yes | 0.796 ± 0.012 | 0.000 ± 0.000 | 0.42 |
| flood | 0.95 | BCAST_RC | yes | 0.686 ± 0.009 | 0.674 ± 0.008 | 0.66 |
| flood | 0.9 | HYBRID | yes | 0.857 ± 0.002 | 0.842 ± 0.002 | 0.78 |
| flood | 0.9 | AE_INV | yes | 0.789 ± 0.014 | 0.000 ± 0.000 | 0.59 |
| flood | 0.9 | BCAST_RC | yes | 0.531 ± 0.008 | 0.517 ± 0.008 | 0.94 |
| flood | 0.8 | HYBRID | yes | 0.294 ± 0.006 | 0.266 ± 0.005 | 1.28 |
| flood | 0.8 | AE_INV | yes | 0.779 ± 0.007 | 0.000 ± 0.000 | 0.93 |
| flood | 0.8 | BCAST_RC | yes | 0.396 ± 0.015 | 0.379 ± 0.013 | 1.50 |
| suppress | 0.99 | HYBRID | yes | 1.000 ± 0.000 | 1.000 ± 0.000 | 0.17 |
| suppress | 0.99 | AE_INV | yes | 0.797 ± 0.009 | 0.000 ± 0.000 | 0.25 |
| suppress | 0.99 | BCAST_RC | yes | 0.841 ± 0.013 | 0.833 ± 0.013 | 0.39 |
| suppress | 0.95 | HYBRID | yes | 1.000 ± 0.000 | 1.000 ± 0.000 | 0.19 |
| suppress | 0.95 | HYBRID | NO | 1.000 ± 0.000 | 1.000 ± 0.000 | 0.19 |
| suppress | 0.95 | AE_INV | yes | 0.796 ± 0.012 | 0.000 ± 0.000 | 0.25 |
| suppress | 0.95 | BCAST_RC | yes | 0.850 ± 0.007 | 0.842 ± 0.006 | 0.41 |
| suppress | 0.9 | HYBRID | yes | 1.000 ± 0.000 | 1.000 ± 0.000 | 0.21 |
| suppress | 0.9 | HYBRID | NO | 1.000 ± 0.000 | 1.000 ± 0.000 | 0.21 |
| suppress | 0.9 | AE_INV | yes | 0.790 ± 0.015 | 0.000 ± 0.000 | 0.25 |
| suppress | 0.9 | BCAST_RC | yes | 0.847 ± 0.009 | 0.838 ± 0.008 | 0.44 |
| suppress | 0.8 | HYBRID | yes | 1.000 ± 0.000 | 1.000 ± 0.000 | 0.27 |
| suppress | 0.8 | HYBRID | NO | 1.000 ± 0.000 | 1.000 ± 0.000 | 0.25 |
| suppress | 0.8 | AE_INV | yes | 0.805 ± 0.007 | 0.000 ± 0.000 | 0.25 |
| suppress | 0.8 | BCAST_RC | yes | 0.868 ± 0.005 | 0.857 ± 0.004 | 0.50 |

## Group C — environments (N = 3 000)

rooms: 6 rooms × 500, people change room every ~20 min on average, 1 h. city: encounter process, 1.5 encounters/h, 20 communities, 24 h.

| env | strategy | variant | seeds | mean | p10 | LISTEN | COURIER | t50 (min) | reach50 | energy mAh (radio, nRF52840 currents) |
|---|---|---|---|---|---|---|---|---|---|---|
| city | HYBRID | beacons on | 2 | 1.000 ± 0.000 | 0.999 ± 0.000 | 0.999 ± 0.000 | 1.000 ± 0.000 | 390 | 1.000 ± 0.000 | 15.3 |
| city | HYBRID | beacons sent, weight off | 2 | 1.000 ± 0.000 | 0.999 ± 0.000 | 1.000 ± 0.000 | 1.000 ± 0.000 | 390 | 1.000 ± 0.000 | 15.5 |
| city | HYBRID | no burst mode | 2 | 0.493 ± 0.017 | 0.373 ± 0.015 | 0.431 ± 0.017 | 0.506 ± 0.020 | 945 | 0.486 ± 0.025 | 9.6 |
| city | AE_INV | default | 2 | 0.797 ± 0.001 | 0.000 ± 0.000 | 0.000 ± 0.000 | 1.000 ± 0.000 | 525 | 1.000 ± 0.000 | 9.8 |
| city | PAIRWISE | default | 2 | 0.797 ± 0.001 | 0.000 ± 0.000 | 0.000 ± 0.000 | 1.000 ± 0.000 | 525 | 1.000 ± 0.000 | 9.8 |
| city | BCAST_RC | default | 2 | 0.582 ± 0.000 | 0.465 ± 0.001 | 0.585 ± 0.005 | 0.579 ± 0.000 | 885 | 0.599 ± 0.008 | 10.0 |
| rooms | HYBRID | beacons off (v1) | 1 | 0.976 | 0.971 | 0.976 | 0.976 | 24 | 0.987 | 1.9 |
| rooms | HYBRID | beacons on | 2 | 0.968 ± 0.004 | 0.962 ± 0.004 | 0.968 ± 0.004 | 0.968 ± 0.004 | 24 | 0.985 ± 0.003 | 1.9 |
| rooms | AE_INV | default | 1 | 0.754 | 0.000 | 0.000 | 0.946 | 36 | 1.000 | 1.9 |
| rooms | PAIRWISE | default | 1 | 0.714 | 0.000 | 0.000 | 0.893 | 38 | 0.997 | 1.9 |
| rooms | BCAST_RC | default | 1 | 0.647 | 0.638 | 0.647 | 0.647 | 26 | 0.656 | 2.0 |

## Group D — interdiction: two rooms joined only by bridge couriers (N = 400, 2 h)

| bridges | bridges silenced | mean | p10 |
|---|---|---|---|
| 2 | no | 0.835 ± 0.286 | 0.823 ± 0.306 |
| 2 | yes | 0.496 ± 0.001 | 0.482 ± 0.014 |
| 8 | no | 1.000 ± 0.000 | 1.000 ± 0.000 |
| 8 | yes | 0.480 ± 0.002 | 0.476 ± 0.011 |

## Group E — storage exhaustion: capacity 600 slots, flooders at 5 events/s (N = 500, 60 min)

| admission | quota/min | h | mean | p10 | mean junk stored | honest refused (full) | honest refused (quota) | honest evicted |
|---|---|---|---|---|---|---|---|---|
| naive | – | 1.0 | 1.000 ± 0.000 | 1.000 ± 0.000 | 0 | 0 | 0 | 0 |
| naive | – | 0.98 | 0.527 ± 0.005 | 0.363 ± 0.041 | 393 | 1581702 | 0 | 0 |
| naive | – | 0.95 | 0.242 ± 0.011 | 0.156 ± 0.008 | 508 | 2634428 | 0 | 0 |
| quota | 60.0 | 1.0 | 1.000 ± 0.000 | 1.000 ± 0.000 | 0 | 0 | 4584 | 0 |
| quota | 60.0 | 0.98 | 0.882 ± 0.005 | 0.846 ± 0.002 | 253 | 292833 | 94312 | 0 |
| quota | 60.0 | 0.95 | 0.821 ± 0.003 | 0.787 ± 0.004 | 289 | 348112 | 132510 | 0 |
| quota | 150.0 | 1.0 | 1.000 ± 0.000 | 1.000 ± 0.000 | 0 | 0 | 0 | 0 |
| quota | 150.0 | 0.98 | 0.580 ± 0.007 | 0.487 ± 0.010 | 372 | 1346366 | 17664 | 0 |
| quota | 150.0 | 0.95 | 0.488 ± 0.005 | 0.411 ± 0.005 | 415 | 1526515 | 99071 | 0 |
| quota_strata | 150.0 | 1.0 | 1.000 ± 0.000 | 1.000 ± 0.000 | 0 | 0 | 0 | 0 |
| quota_strata | 150.0 | 0.98 | 0.634 ± 0.006 | 0.590 ± 0.004 | 351 | 199049 | 27553 | 1356928 |
| quota_strata | 150.0 | 0.95 | 0.598 ± 0.004 | 0.566 ± 0.004 | 374 | 215181 | 97863 | 1299925 |
| strata | – | 1.0 | 1.000 ± 0.000 | 1.000 ± 0.000 | 0 | 0 | 0 | 0 |
| strata | – | 0.98 | 0.599 ± 0.006 | 0.540 ± 0.005 | 365 | 244633 | 0 | 1532269 |
| strata | – | 0.95 | 0.394 ± 0.004 | 0.343 ± 0.002 | 451 | 436075 | 0 | 2001660 |

## Group F — sensitivity (N = 1 000 auditorium, 30 min, 2 seeds)

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
| N=1000, strategy=HYBRID, rc_scope=cell, rc_kappa=3.0, T=1800 | 2 | 0.757 ± 0.002 | 0.737 ± 0.001 | 0.659 ± 0.007 | 1.07 |
| N=1000, strategy=HYBRID, rc_scope=domain, rc_kappa=1.0, T=1800 | 2 | 0.823 ± 0.006 | 0.812 ± 0.006 | 0.787 ± 0.003 | 0.29 |

## Group H

| configuration | seeds | mean | p10 | reach80 | G |
|---|---|---|---|---|---|
| N=100, strategy=HYBRID, sdb=False, env=auditorium, T=3600 | 3 | 1.000 ± 0.000 | 1.000 ± 0.000 | 1.000 ± 0.000 | 0.07 |
| N=1000, strategy=HYBRID, sdb=False, env=auditorium, T=3600 | 3 | 0.945 ± 0.002 | 0.941 ± 0.002 | 0.933 ± 0.000 | 0.28 |
| N=3000, env=city, strategy=HYBRID, sdb=False, T=86400, dt=30.0 | 2 | 1.000 ± 0.000 | 1.000 ± 0.000 | 1.000 ± 0.000 | 0.02 |
| N=3000, strategy=HYBRID, sdb=False, env=auditorium, T=3600 | 2 | 0.398 ± 0.005 | 0.385 ± 0.005 | 0.385 ± 0.008 | 0.34 |
| N=500, strategy=HYBRID, sdb=False, env=auditorium, T=3600 | 3 | 1.000 ± 0.000 | 1.000 ± 0.000 | 1.000 ± 0.000 | 0.23 |
| N=5000, strategy=HYBRID, sdb=False, env=auditorium, T=3600 | 1 | 0.245 | 0.224 | 0.019 | 0.35 |
