danindiana/zemizdat/06_simulation/results/fig_A_timeseries_N3000.png

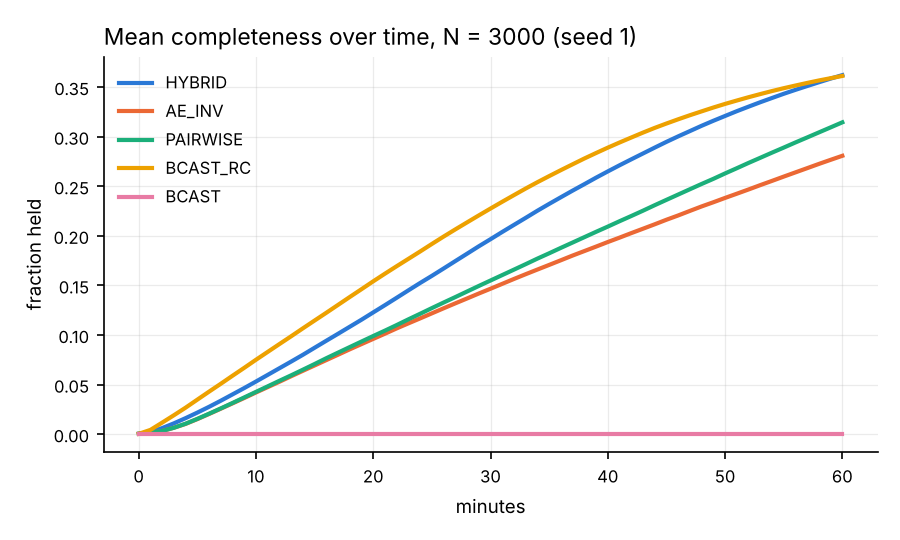
06_simulation/results/fig_A_timeseries_N3000.png
