danindiana/zemizdat/06_simulation/results/fig_C_rooms.png

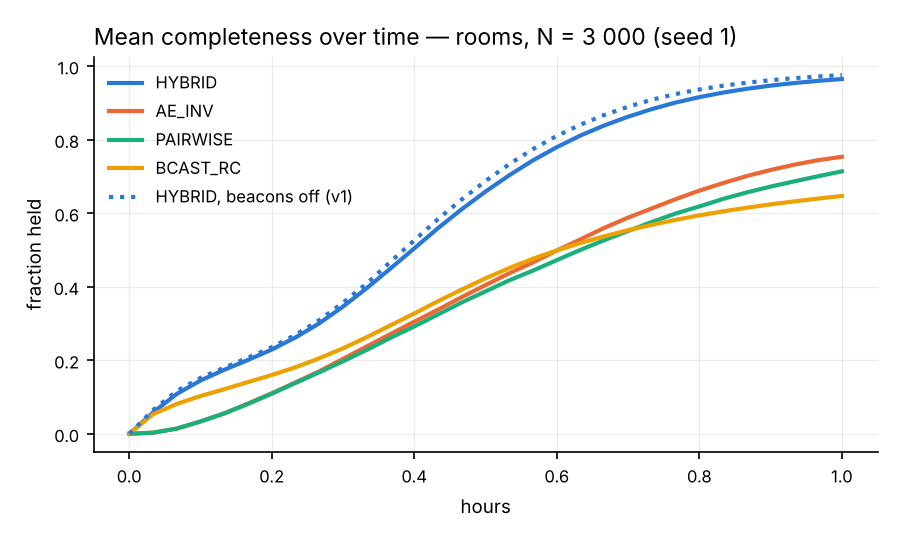
06_simulation/results/fig_C_rooms.png
