danindiana/zemizdat/05_hardware/zb1/cad/docs/zb1_assembly_top.pdf

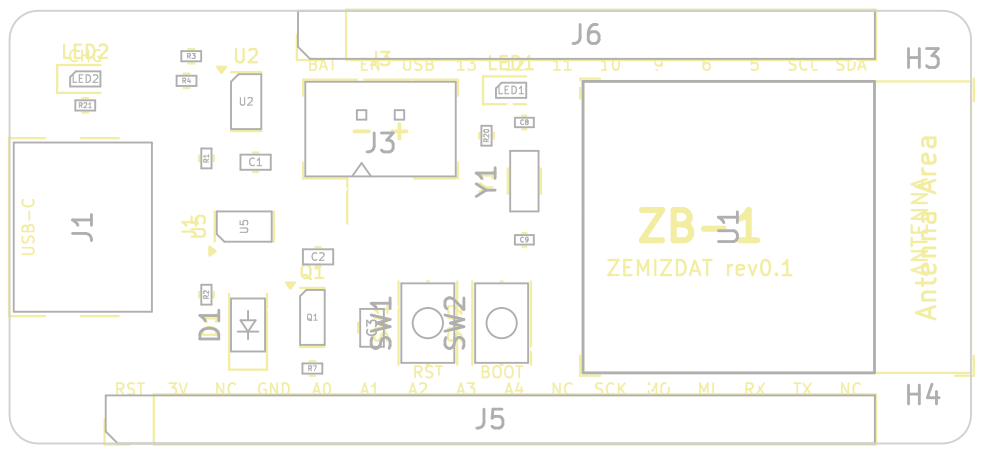
[picture p33: page 1]

Id: 1/1 Title: File: zb1.kicad_pcb Sheet: ZB-1
