danindiana/zemizdat/05_hardware/zb1/cad/docs/zb1_schematic.pdf

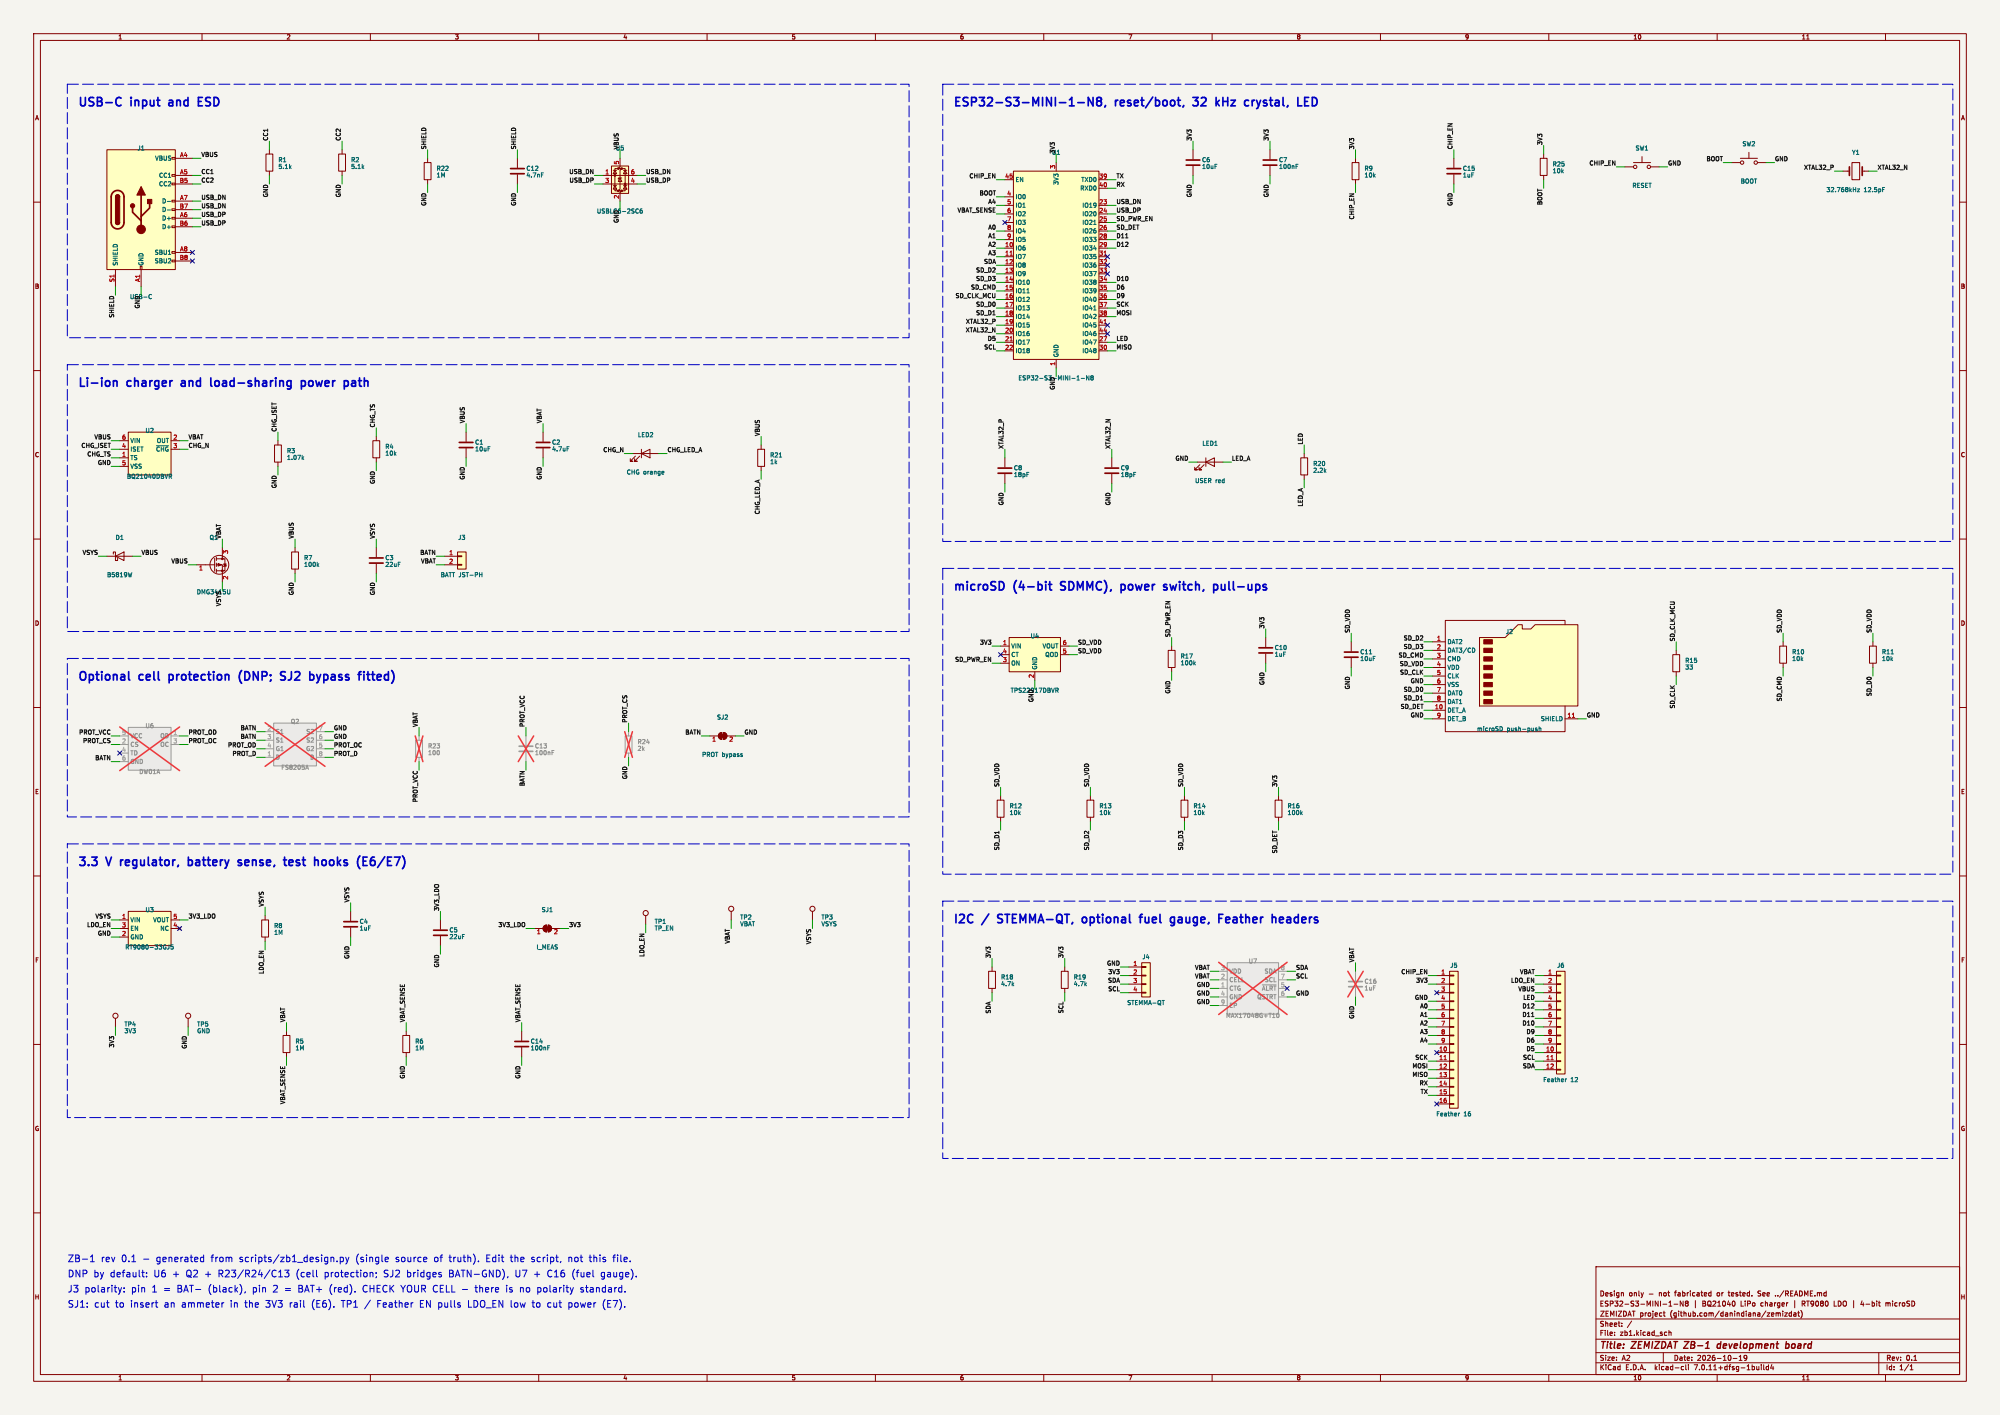
[picture p34: page 1]

2 ON 3 CT 4 QOD 5 VOUT 6 U4 TPS22917DBVR

Optional cell protection (DNP; SJ2 bypass fitted)

I2C / STEMMA-QT, optional fuel gauge, Feather headers

SJ1: cut to insert an ammeter in the 3V3 rail (E6). TP1 / Feather EN pulls LDO_EN low to cut power (E7).
