danindiana/zemizdat/05_hardware/zb1/cad/zb1.kicad_pcb

## KiCad design 05_hardware/zb1/cad/zb1.kicad_pcb (2026-10-20)

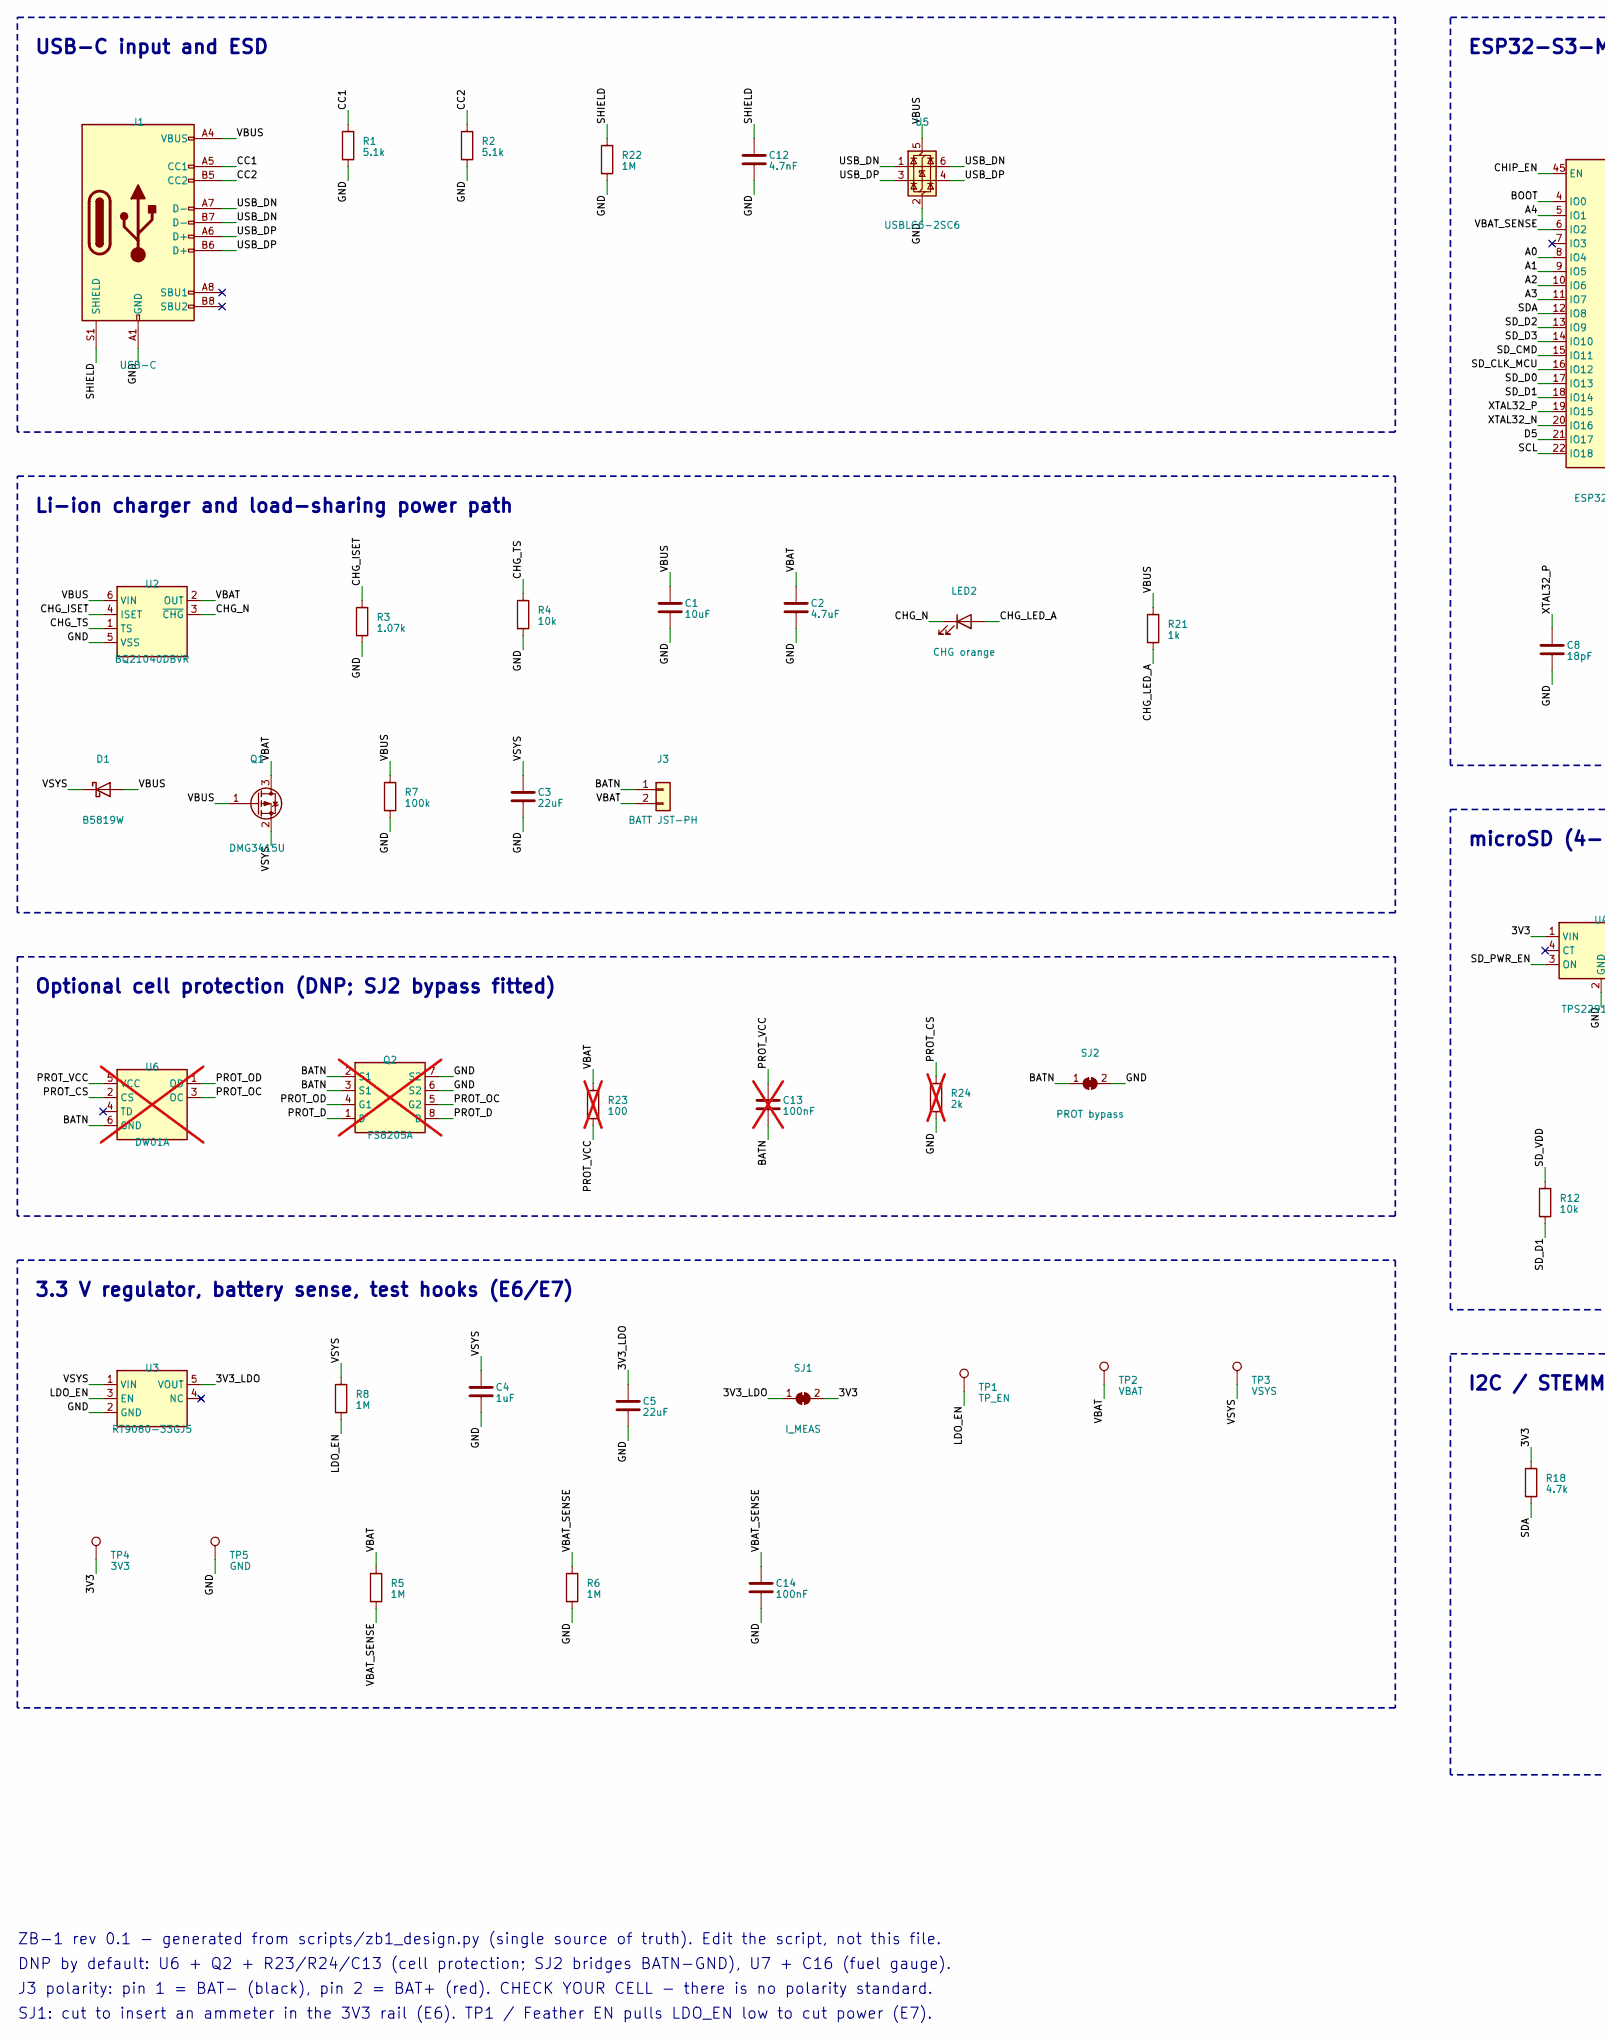
[picture p35: schematic zb1.kicad_sch, ZEMIZDAT ZB-1 development board, part in row 1, column 1]

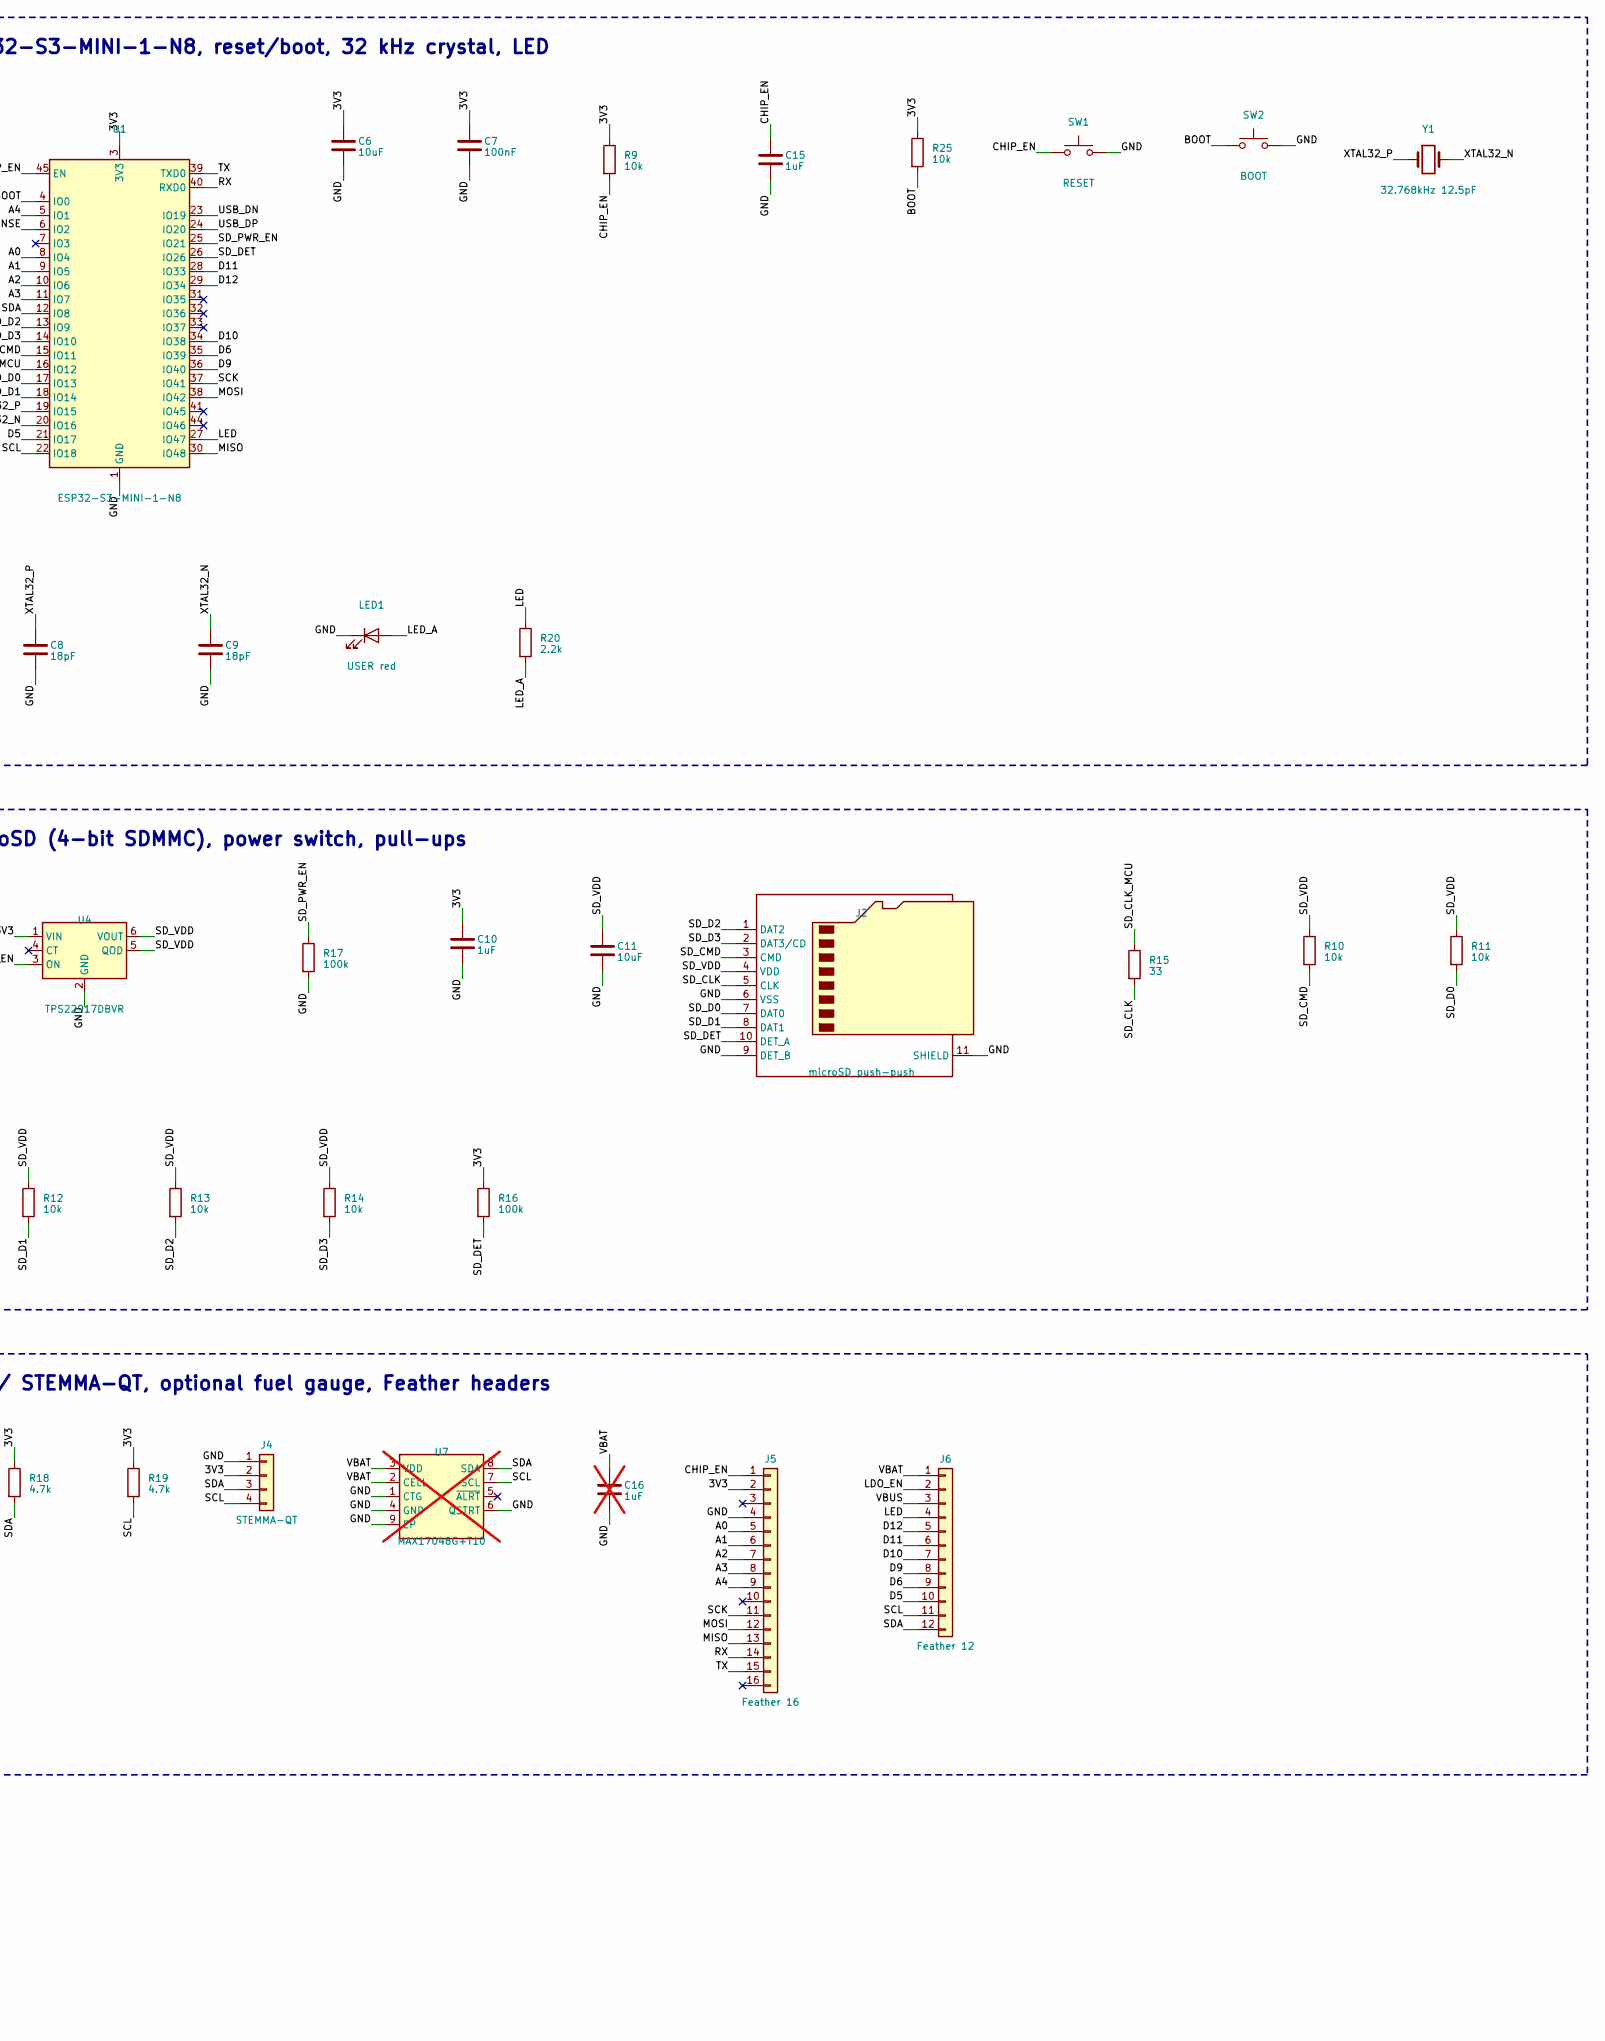
[picture p36: schematic zb1.kicad_sch, ZEMIZDAT ZB-1 development board, part in row 1, column 2]

Parts:
C1, C6, C11: 10uF; C_0603_1608Metric; MPN 10uF X5R/X7R
C2: 4.7uF; C_0603_1608Metric; MPN 4.7uF X5R/X7R
C3, C5: 22uF; C_0805_2012Metric; MPN 22uF X5R/X7R
C4, C10, C15: 1uF; C_0402_1005Metric; MPN 1uF X5R/X7R
C7, C14: 100nF; C_0402_1005Metric; MPN 100nF X5R/X7R
C8, C9: 18pF; C_0402_1005Metric; MPN 18pF C0G
C12: 4.7nF; C_0402_1005Metric; MPN 4.7nF X5R/X7R
C13: 100nF; C_0402_1005Metric; MPN 100nF X5R/X7R; not fitted
C16: 1uF; C_0402_1005Metric; MPN 1uF X5R/X7R; not fitted
D1: B5819W; D_SOD-123; MPN B5819W SOD-123
J1: USB-C; USB_C_Receptacle_HRO_TYPE-C-31-M-12; MPN HRO TYPE-C-31-M-12
J2: microSD push-push; microSD_HC_Hirose_DM3AT-SF-PEJM5; MPN Hirose DM3AT-SF-PEJM5
J3: BATT JST-PH; JST_PH_B2B-PH-SM4-TB_1x02-1MP_P2.00mm_Vertical; MPN JST B2B-PH-SM4-TB
J4: STEMMA-QT; JST_SH_BM04B-SRSS-TB_1x04-1MP_P1.00mm_Vertical; MPN JST BM04B-SRSS-TB
J5: Feather 16; PinHeader_1x16_P2.54mm_Vertical; MPN 1x16 2.54mm header (ship loose)
J6: Feather 12; PinHeader_1x12_P2.54mm_Vertical; MPN 1x12 2.54mm header (ship loose)
LED1: USER red; LED_0603_1608Metric; MPN red 0603 LED
LED2: CHG orange; LED_0603_1608Metric; MPN orange 0603 LED
Q1: DMG3415U; SOT-23; MPN Diodes DMG3415U-7
Q2: FS8205A; TSSOP-8_4.4x3mm_P0.65mm; MPN Fortune FS8205A; not fitted
R1, R2: 5.1k; R_0402_1005Metric; MPN 5.1k 1% 0402
R3: 1.07k; R_0402_1005Metric; MPN 1.07k 1% 0402
R4: 10k; R_0402_1005Metric; MPN 10k 1% (or 10k NTC on the cell)
R5, R6, R8, R22: 1M; R_0402_1005Metric; MPN 1M 1% 0402
R7, R16, R17: 100k; R_0402_1005Metric; MPN 100k 1% 0402
R9, R10, R11, R12, R13, R14, R25: 10k; R_0402_1005Metric; MPN 10k 1% 0402
R15: 33; R_0402_1005Metric; MPN 33 1% 0402
R18, R19: 4.7k; R_0402_1005Metric; MPN 4.7k 1% 0402
R20: 2.2k; R_0402_1005Metric; MPN 2.2k 1% 0402
R21: 1k; R_0402_1005Metric; MPN 1k 1% 0402
R23: 100; R_0402_1005Metric; MPN 100 1% 0402; not fitted
R24: 2k; R_0402_1005Metric; MPN 2k 1% 0402; not fitted
SJ1: I_MEAS; SolderJumper-2_P1.3mm_Bridged_RoundedPad1.0x1.5mm; MPN (PCB) cut to measure current
SJ2: PROT bypass; SolderJumper-2_P1.3mm_Bridged_RoundedPad1.0x1.5mm; MPN (PCB) cut if U6/Q2 fitted
SW1: RESET; SW_Push_1P1T_NO_CK_KMR2; MPN C&K KMR221GLFS
SW2: BOOT; SW_Push_1P1T_NO_CK_KMR2; MPN C&K KMR221GLFS
TP1: TP_EN; TestPoint_Pad_D1.0mm; MPN (PCB)
TP2: VBAT; TestPoint_Pad_D1.0mm; MPN (PCB)
TP3: VSYS; TestPoint_Pad_D1.0mm; MPN (PCB)
TP4: 3V3; TestPoint_Pad_D1.0mm; MPN (PCB)
TP5: GND; TestPoint_Pad_D1.0mm; MPN (PCB)
U1: ESP32-S3-MINI-1-N8; ESP32-S3-MINI-1; MPN Espressif ESP32-S3-MINI-1-N8
U2: BQ21040DBVR; SOT-23-6; MPN TI BQ21040DBVR
U3: RT9080-33GJ5; SOT-23-5; MPN Richtek RT9080-33GJ5
U4: TPS22917DBVR; SOT-23-6; MPN TI TPS22917DBVR
U5: USBLC6-2SC6; SOT-23-6; MPN ST USBLC6-2SC6
U6: DW01A; SOT-23-6; MPN Fortune DW01A; not fitted
U7: MAX17048G+T10; TDFN-8-1EP_2x2mm_P0.5mm_EP0.8x1.2mm; MPN Analog Devices MAX17048G+T10; not fitted
Y1: 32.768kHz 12.5pF; Crystal_SMD_3215-2Pin_3.2x1.5mm; MPN Epson FC-135 32.768kHz 12.5pF

Connections:
3V3: C6.1, C7.1, C10.1, J4.2, J5.2, R9.1, R16.1, R18.1, R19.1, R25.1, SJ1.2 (B), TP4.1, U1.3 (3V3), U4.1 (VIN)
3V3_LDO: C5.1, SJ1.1 (A), U3.5 (VOUT)
A0: J5.5, U1.8 (IO4)
A1: J5.6, U1.9 (IO5)
A2: J5.7, U1.10 (IO6)
A3: J5.8, U1.11 (IO7)
A4: J5.9, U1.5 (IO1)
BATN: C13.2, J3.1, Q2.2 (S1), Q2.3 (S1), SJ2.1 (A), U6.6 (GND)
BOOT: R25.2, SW2.1, U1.4 (IO0)
CC1: J1.A5 (CC1), R1.1
CC2: J1.B5 (CC2), R2.1
CHG_ISET: R3.1, U2.4 (ISET)
CHG_LED_A: LED2.2 (A), R21.2
CHG_N: LED2.1 (K), U2.3 (~CHG)
CHG_TS: R4.1, U2.1 (TS)
CHIP_EN: C15.1, J5.1, R9.2, SW1.1, U1.45 (EN)
D5: J6.10, U1.21 (IO17)
D6: J6.9, U1.35 (IO39)
D9: J6.8, U1.36 (IO40)
D10: J6.7, U1.34 (IO38)
D11: J6.6, U1.28 (IO33)
D12: J6.5, U1.29 (IO34)
GND: C1.2, C2.2, C3.2, C4.2, C5.2, C6.2, C7.2, C8.2, C9.2, C10.2, C11.2, C12.2, C14.2, C15.2, C16.2, J1.A1 (GND), J1.A12 (GND), J1.B1 (GND), J1.B12 (GND), J2.6 (VSS), J2.9 (DET_B), J2.11 (SHIELD), J4.1, J5.4, LED1.1 (K), Q2.6 (S2), Q2.7 (S2), R1.2, R2.2, R3.2, R4.2, R6.2, R7.2, R17.2, R22.2, R24.2, SJ2.2 (B), SW1.2, SW2.2, TP5.1, U1.1 (GND), U1.2 (GND), U1.42 (GND), U1.43 (GND), U1.46 (GND), U1.47 (GND), U1.48 (GND), U1.49 (GND), U1.50 (GND), U1.51 (GND), U1.52 (GND), U1.53 (GND), U1.54 (GND), U1.55 (GND), U1.56 (GND), U1.57 (GND), U1.58 (GND), U1.59 (GND), U1.60 (GND), U1.61 (GND), U1.62 (GND), U1.63 (GND), U1.64 (GND), U1.65 (GND), U2.5 (VSS), U3.2 (GND), U4.2 (GND), U5.2 (GND), U7.1 (CTG), U7.4 (GND), U7.6 (QSTRT), U7.9 (EP)
LDO_EN: J6.2, R8.2, TP1.1, U3.3 (EN)
LED: J6.4, R20.1, U1.27 (IO47)
LED_A: LED1.2 (A), R20.2
MISO: J5.13, U1.30 (IO48)
MOSI: J5.12, U1.38 (IO42)
PROT_CS: R24.1, U6.2 (CS)
PROT_D: Q2.1 (D), Q2.8 (D)
PROT_OC: Q2.5 (G2), U6.3 (OC)
PROT_OD: Q2.4 (G1), U6.1 (OD)
PROT_VCC: C13.1, R23.2, U6.5 (VCC)
RX: J5.14, U1.40 (RXD0)
SCK: J5.11, U1.37 (IO41)
SCL: J4.4, J6.11, R19.2, U1.22 (IO18), U7.7 (SCL)
SDA: J4.3, J6.12, R18.2, U1.12 (IO8), U7.8 (SDA)
SD_CLK: J2.5 (CLK), R15.2
SD_CLK_MCU: R15.1, U1.16 (IO12)
SD_CMD: J2.3 (CMD), R10.2, U1.15 (IO11)
SD_D0: J2.7 (DAT0), R11.2, U1.17 (IO13)
SD_D1: J2.8 (DAT1), R12.2, U1.18 (IO14)
SD_D2: J2.1 (DAT2), R13.2, U1.13 (IO9)
SD_D3: J2.2 (DAT3/CD), R14.2, U1.14 (IO10)
SD_DET: J2.10 (DET_A), R16.2, U1.26 (IO26)
SD_PWR_EN: R17.1, U1.25 (IO21), U4.3 (ON)
SD_VDD: C11.1, J2.4 (VDD), R10.1, R11.1, R12.1, R13.1, R14.1, U4.5 (QOD), U4.6 (VOUT)
SHIELD: C12.1, J1.S1 (SHIELD), R22.1
TX: J5.15, U1.39 (TXD0)
USB_DN: J1.A7 (D-), J1.B7 (D-), U1.23 (IO19), U5.1 (I/O1), U5.6 (I/O1)
USB_DP: J1.A6 (D+), J1.B6 (D+), U1.24 (IO20), U5.3 (I/O2), U5.4 (I/O2)
VBAT: C2.1, C16.1, J3.2, J6.1, Q1.3 (D), R5.1, R23.1, TP2.1, U2.2 (OUT), U7.2 (CELL), U7.3 (VDD)
VBAT_SENSE: C14.1, R5.2, R6.1, U1.6 (IO2)
VBUS: C1.1, D1.2 (A), J1.A4 (VBUS), J1.A9 (VBUS), J1.B4 (VBUS), J1.B9 (VBUS), J6.3, Q1.1 (G), R7.1, R21.1, U2.6 (VIN), U5.5 (VBUS)
VSYS: C3.1, C4.1, D1.1 (K), Q1.2 (S), R8.1, TP3.1, U3.1 (VIN)
XTAL32_N: C9.1, U1.20 (IO16), Y1.2
XTAL32_P: C8.1, U1.19 (IO15), Y1.1

Notes on the sheet:
USB-C input and ESD
Li-ion charger and load-sharing power path
Optional cell protection (DNP; SJ2 bypass fitted)
3.3 V regulator, battery sense, test hooks (E6/E7)
ESP32-S3-MINI-1-N8, reset/boot, 32 kHz crystal, LED
microSD (4-bit SDMMC), power switch, pull-ups
I2C / STEMMA-QT, optional fuel gauge, Feather headers
ZB-1 rev 0.1 - generated from scripts/zb1_design.py (single source of truth). Edit the script, not this file.
DNP by default: U6 + Q2 + R23/R24/C13 (cell protection; SJ2 bridges BATN-GND), U7 + C16 (fuel gauge).
J3 polarity: pin 1 = BAT- (black), pin 2 = BAT+ (red). CHECK YOUR CELL - there is no polarity standard.
SJ1: cut to insert an ammeter in the 3V3 rail (E6). TP1 / Feather EN pulls LDO_EN low to cut power (E7).

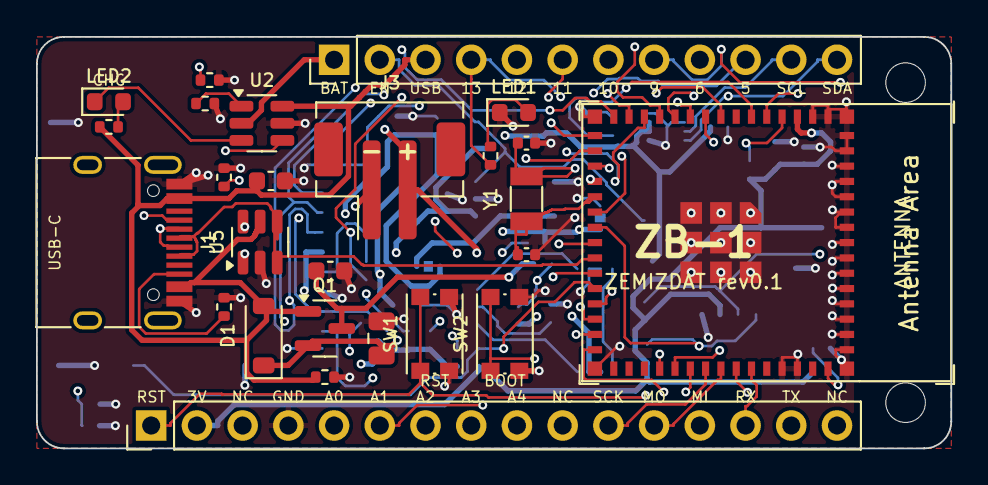
[picture p37: board zb1.kicad_pcb from above]

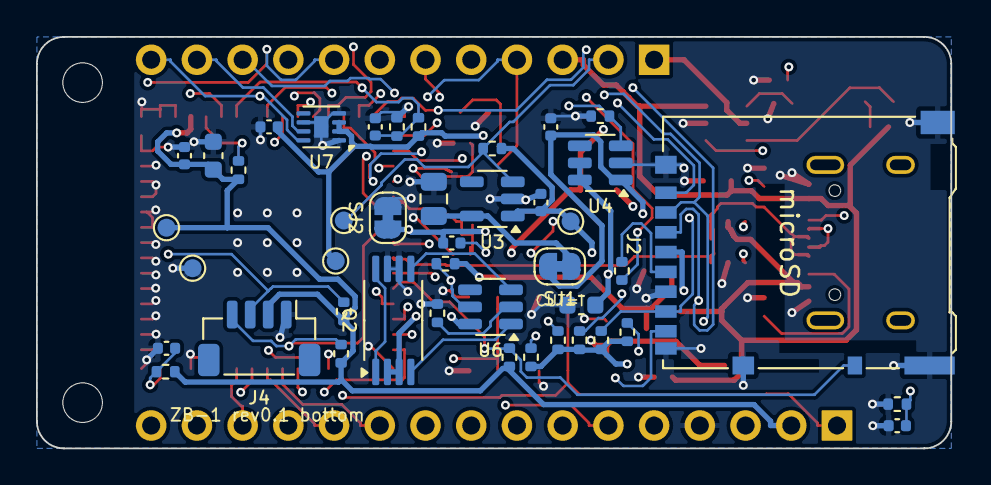
[picture p38: board zb1.kicad_pcb from below]

Board: 4 copper layers, 50.8 x 22.9 mm, 71 parts (43 on the bottom side), 57 nets.

Other parts of the board:
H3, H4: M2; MountingHole_2.2mm_M2
