danindiana/zemizdat/05_hardware/zb1/firmware/zb1_bringup/zb1_board.h

/* ZB-1 pin assignments for sketches built with the generic "ESP32S3 Dev Module" board.
 * Identical to arduino/variants/zemizdat_zb1/pins_arduino.h and ../../pinmap.csv. */
#pragma once
#define ZB1_BTN_BOOT    0
#define ZB1_VBAT_SENSE  2
#define ZB1_I2C_SDA     8
#define ZB1_I2C_SCL     18
#define ZB1_SD_D2       9
#define ZB1_SD_D3       10
#define ZB1_SD_CMD      11
#define ZB1_SD_CLK      12
#define ZB1_SD_D0       13
#define ZB1_SD_D1       14
#define ZB1_SD_PWR_EN   21
#define ZB1_SD_DETECT   26
#define ZB1_LED         47
