danindiana/zemizdat/05_hardware/zb1/firmware/zb1_e1_test/zb1_e1_test.ino

/* ZB-1 experiment E1 harness: BLE 5 extended advertising, AUX_CHAIN_IND chaining and anonymous
 * (AdvA-less) advertising, measured with a second board and an nRF52840 sniffer.
 * All code lives in e1_main.cpp (keeps Arduino's prototype generator out of the way).
 * Build flags and procedure: README.md in this folder. */
