danindiana/zemizdat/(commit log)

2026-10-19 ZEMIZDAT-ARGON-1.0: formal model, ZEMIZDAT-PROTO-1.0 spec, reference code, simulator, adversarial review
    - Formal model: invariants I1-I10, conditional liveness, impossibility results A-J
    - Protocol: connectionless BLE 5 extended-advertising carousel, hash-list content ids,
    per-chunk verification, crash-safe NOR store, crowd/burst rate control
    - Reference implementations: Python (31 tests incl. every-byte power cuts) and C99
    receive path (byte-identical vectors, 2M-frame ASan/UBSan fuzz)
    - Simulator + 377-run campaign (groups A-H), results and figures
    - Hardware assessment, dev-board shortlist, prior-art survey, test plan E1-E7
    - Audit of the earlier Gemini run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
2026-10-19 Add ZB-1 development board design (ESP32-S3, LiPo charging, microSD)
    - 05_hardware/zb1/README.md: requirements traceability to ZEMIZDAT-PROTO-1.0,
    chip selection, power architecture and budget (BLE RX 93 mA per module
    datasheet), schematic description, layout rules, microSD capacity notes
    (SDSC/SDHC/SDXC to 2 TB; exFAT via SdFat or FAT32), bring-up/test plan,
    risks, ZB-2 (nRF52840) recommendation
    - pinmap.csv, bom.csv (prices are estimates)
    - Arduino boards.txt entry + zemizdat_zb1 variant (SDMMC defaults)
    - bring-up sketch: anonymous ext adv + passive scan through zm_core.c,
    SD power/mount test, VBAT; compile-checked on arduino-esp32 2.0.9
    - diagrams 11 (block) and 12 (power tree)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
    [bom.csv, pinmap.csv]
2026-10-20 Add ZB-1 CAD package: KiCad 7 schematic, routed 4-layer PCB, fab outputs, STEP, renders
    05_hardware/zb1/cad/:
    - zb1.kicad_sch generated from scripts/zb1_design.py; exported netlist verified pin by pin
    (69 parts, 57 nets, 264 connections), PCB pads cross-checked the same way
    - zb1.kicad_pcb: Feather 50.8 x 22.86 mm, 4 layers (In1 solid GND), antenna keep-out on all
    layers, microSD on the bottom; fully routed (0 unconnected, 0 clearance/hole errors);
    8 mechanical waivers and cosmetic silk warnings documented in README section 5
    - fab/: Gerber X2 + Excellon (zip), pick-and-place, grouped BOM; docs/: schematic and
    assembly PDFs, drill maps; 3d/zb1.step; images/: layer plots and textured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
    [bom.csv, pinmap.csv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]
2026-10-20 Add ZB-1 E1 harness (chained anonymous extended advertising)
    05_hardware/zb1/firmware/zb1_e1_test/: contributed draft reviewed against NimBLE-Arduino
    1.4.3 and fixed (include paths, anonymous addr-type check, ext-adv data-length option that
    would otherwise overflow a 251 B buffer, host-task stack use, per-advertiser reassembly,
    mbedTLS 3 compatibility). Adds the test_plan E1 case (720 B, 3-PDU event) as default, 30/100 %
    scan duty, fragment histograms and pass-rate line. Compiles for esp32s3 and zemizdat_zb1
    (core 2.0.9); not yet run on hardware.
    Claude-Session: https://claude.ai/code/session_014PeYiMq2k9STXPrns1oQTw
    [e1_main.cpp, zb1_e1_test.ino]
2026-10-21 Open-source the project: Apache-2.0 / CERN-OHL-P-2.0 / CC-BY-4.0
    Copyright 2026 Benjamin W. Denio.
    - LICENSE: Apache-2.0 (code; what GitHub detects)
    - LICENSES/: Apache-2.0, CERN-OHL-P-2.0 (ZB-1 hardware design), CC-BY-4.0 (documentation,
    diagrams, data); texts from the SPDX license-list-data repository
    - LICENSING.md: which paths fall under which licence, third-party material, obligations
    - NOTICE: copyright and the Espressif footprint/STEP (CC-BY-SA 4.0 with KiCad design exception)
    - README badge and licence section; CAD README and lib/ATTRIBUTION.md licence notes
    Claude-Session: https://claude.ai/code/session_014PeYiMq2k9STXPrns1o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
