danindiana/zemizdat/(notices)

Notices in the files:
README.md:
license: Apache-2.0 / CERN-OHL-P-2.0 / CC-BY-4.0
